TheWayForward/Domesitc-FPGA-Demo-Board/demo/blink/impl/pnr/blink.rpt.txt

//Copyright (C)2014-2022 Gowin Semiconductor Corporation.
//All rights reserved.

1. PnR Messages

  <Report Title>: PnR Report
  <Design File>: C:\Users\TrWyFowrd\Desktop\temp\design_main_test\blink\impl\gwsynthesis\blink.vg
  <Physical Constraints File>: C:\Users\TrWyFowrd\Desktop\temp\design_main_test\blink\src\blink.cst
  <Timing Constraints File>: ---
  <PnR Version>: V1.9.8.10
  <Part Number>: GW2A-LV18PG256C8/I7
  <Device>: GW2A-18
  <Device Version>: C
  <Created Time>:Wed May 24 14:20:20 2023

2. PnR Details

  Running placement:
    Placement Phase 0: CPU time = 0h 0m 0.01s, Elapsed time = 0h 0m 0.012s
    Placement Phase 1: CPU time = 0h 0m 0.185s, Elapsed time = 0h 0m 0.184s
    Placement Phase 2: CPU time = 0h 0m 0s, Elapsed time = 0h 0m 0.001s
    Placement Phase 3: CPU time = 0h 0m 0.645s, Elapsed time = 0h 0m 0.647s
    Total Placement: CPU time = 0h 0m 0.84s, Elapsed time = 0h 0m 0.844s
 Running routing:
    Routing Phase 0: CPU time = 0h 0m 0.001s, Elapsed time = 0h 0m 0.001s
    Routing Phase 1: CPU time = 0h 0m 0.095s, Elapsed time = 0h 0m 0.099s
    Routing Phase 2: CPU time = 0h 0m 0.063s, Elapsed time = 0h 0m 0.061s
    Total Routing: CPU time = 0h 0m 0.159s, Elapsed time = 0h 0m 0.161s
 Generate output files:
    CPU time = 0h 0m 1s, Elapsed time = 0h 0m 1s

 Total Time and Memory Usage: CPU time = 0h 0m 2s, Elapsed time = 0h 0m 2s, Peak memory usage = 320MB

3. Resource Usage Summary

  ----------------------------------------------------------
  Resources                   | Usage
  ----------------------------------------------------------
  Logic                       | 33/20736  <1%
    --LUT,ALU,ROM16           | 33(9 LUT, 24 ALU, 0 ROM16)
    --SSRAM(RAM16)            | 0
  Register                    | 26/16173  <1%
    --Logic Register as Latch | 0/15552  0%
    --Logic Register as FF    | 26/15552  <1%
    --I/O Register as Latch   | 0/621  0%
    --I/O Register as FF      | 0/621  0%
  CLS                         | 19/10368  <1%
  I/O Port                    | 2
  I/O Buf                     | 2
    --Input Buf               | 1
    --Output Buf              | 1
    --Inout Buf               | 0
  IOLOGIC                     | 0%
  BSRAM                       | 0%
  DSP                         | 0%
  PLL                         | 0/4  0%
  DCS                         | 0/8  0%
  DQCE                        | 0/24  0%
  OSC                         | 0/1  0%
  CLKDIV                      | 0/8  0%
  DLLDLY                      | 0/8  0%
  DQS                         | 0/9  0%
  DHCEN                       | 0/16  0%
  ==========================================================

4. I/O Bank Usage Summary

  -----------------------
  I/O Bank  | Usage       
  -----------------------
  bank 0   | 1/29(3%)    
  bank 1   | 0/20(0%)    
  bank 2   | 0/20(0%)    
  bank 3   | 0/32(0%)    
  bank 4   | 0/36(0%)    
  bank 5   | 0/36(0%)    
  bank 6   | 0/18(0%)    
  bank 7   | 1/16(6%)    
  =======================

5. Global Clock Usage Summary

  -------------------------------
  Global Clock  | Usage       
  -------------------------------
  PRIMARY       | 1/8(13%)
  LW            | 0/8(0%)
  GCLK_PIN      | 1/8(13%)
  PLL           | 0/4(0%)
  CLKDIV        | 0/8(0%)
  DLLDLY        | 0/8(0%)
  ===============================

6. Global Clock Signals

  -------------------------------------------
  Signal         | Global Clock   | Location
  -------------------------------------------
  Clock_d        | PRIMARY        |  TR TL BL
  ===========================================

7. Pinout by Port Name

-------------------------------------------------------------------------------------------------------------------------------------------------------------------------------------------------------------------
Port Name   | Diff Pair | Loc./Bank     | Constraint | Dir.  | Site     | IO Type    | Drive | Pull Mode | PCI Clamp | Hysteresis | Open Drain | Slew Rate | Vref       | Single Resistor | Diff Resistor | BankVccio 
-------------------------------------------------------------------------------------------------------------------------------------------------------------------------------------------------------------------
Clock       |           | H11/0         | Y          | in    | IOT27[A] | LVCMOS18   | NA    | UP        | ON        | NONE       | NA         | NA        | NA         | NA              | NA            | 1.8       
IO_voltage  |           | B13/7         | Y          | out   | IOL8[A]  | LVCMOS18   | 8     | UP        | NA        | NA         | OFF        | FAST      | NA         | OFF             | NA            | 1.8       
===================================================================================================================================================================================================================

8. All Package Pins

----------------------------------------------------------------------------------------------------------------------------------------------------------------------------------------
Loc./Bank| Signal      | Dir.  | Site     | IO Type  | Drive | Pull Mode | PCI Clamp | Hysteresis | Open Drain | Slew Rate | Vref       | Single Resistor | Diff Resistor | Bank Vccio
----------------------------------------------------------------------------------------------------------------------------------------------------------------------------------------
L15/0    | -           | in    | IOT2[A]  | LVCMOS18 | NA    | UP        | ON        | NONE       | NA         | NA        | NA         | NA              | NA            | 1.8  
D16/0    | -           | in    | IOT4[A]  | LVCMOS18 | NA    | UP        | ON        | NONE       | NA         | NA        | NA         | NA              | NA            | 1.8  
E14/0    | -           | in    | IOT4[B]  | LVCMOS18 | NA    | UP        | ON        | NONE       | NA         | NA        | NA         | NA              | NA            | 1.8  
C16/0    | -           | in    | IOT5[A]  | LVCMOS18 | NA    | UP        | ON        | NONE       | NA         | NA        | NA         | NA              | NA            | 1.8  
D15/0    | -           | in    | IOT5[B]  | LVCMOS18 | NA    | UP        | ON        | NONE       | NA         | NA        | NA         | NA              | NA            | 1.8  
E16/0    | -           | in    | IOT6[A]  | LVCMOS18 | NA    | UP        | ON        | NONE       | NA         | NA        | NA         | NA              | NA            | 1.8  
F15/0    | -           | in    | IOT6[B]  | LVCMOS18 | NA    | UP        | ON        | NONE       | NA         | NA        | NA         | NA              | NA            | 1.8  
F13/0    | -           | in    | IOT8[A]  | LVCMOS18 | NA    | UP        | ON        | NONE       | NA         | NA        | NA         | NA              | NA            | 1.8  
G12/0    | -           | in    | IOT8[B]  | LVCMOS18 | NA    | UP        | ON        | NONE       | NA         | NA        | NA         | NA              | NA            | 1.8  
F14/0    | -           | in    | IOT9[A]  | LVCMOS18 | NA    | UP        | ON        | NONE       | NA         | NA        | NA         | NA              | NA            | 1.8  
F16/0    | -           | in    | IOT9[B]  | LVCMOS18 | NA    | UP        | ON        | NONE       | NA         | NA        | NA         | NA              | NA            | 1.8  
F12/0    | -           | in    | IOT12[A] | LVCMOS18 | NA    | UP        | ON        | NONE       | NA         | NA        | NA         | NA              | NA            | 1.8  
G13/0    | -           | in    | IOT12[B] | LVCMOS18 | NA    | UP        | ON        | NONE       | NA         | NA        | NA         | NA              | NA            | 1.8  
G15/0    | -           | in    | IOT13[A] | LVCMOS18 | NA    | UP        | ON        | NONE       | NA         | NA        | NA         | NA              | NA            | 1.8  
G14/0    | -           | in    | IOT13[B] | LVCMOS18 | NA    | UP        | ON        | NONE       | NA         | NA        | NA         | NA              | NA            | 1.8  
G11/0    | -           | in    | IOT14[A] | LVCMOS18 | NA    | UP        | ON        | NONE       | NA         | NA        | NA         | NA              | NA            | 1.8  
H12/0    | -           | in    | IOT14[B] | LVCMOS18 | NA    | UP        | ON        | NONE       | NA         | NA        | NA         | NA              | NA            | 1.8  
G16/0    | -           | in    | IOT16[A] | LVCMOS18 | NA    | UP        | ON        | NONE       | NA         | NA        | NA         | NA              | NA            | 1.8  
H15/0    | -           | in    | IOT16[B] | LVCMOS18 | NA    | UP        | ON        | NONE       | NA         | NA        | NA         | NA              | NA            | 1.8  
H13/0    | -           | in    | IOT18[A] | LVCMOS18 | NA    | UP        | ON        | NONE       | NA         | NA        | NA         | NA              | NA            | 1.8  
J12/0    | -           | in    | IOT18[B] | LVCMOS18 | NA    | UP        | ON        | NONE       | NA         | NA        | NA         | NA              | NA            | 1.8  
H14/0    | -           | in    | IOT20[A] | LVCMOS18 | NA    | UP        | ON        | NONE       | NA         | NA        | NA         | NA              | NA            | 1.8  
H16/0    | -           | in    | IOT20[B] | LVCMOS18 | NA    | UP        | ON        | NONE       | NA         | NA        | NA         | NA              | NA            | 1.8  
J16/0    | -           | in    | IOT22[A] | LVCMOS18 | NA    | UP        | ON        | NONE       | NA         | NA        | NA         | NA              | NA            | 1.8  
J14/0    | -           | in    | IOT22[B] | LVCMOS18 | NA    | UP        | ON        | NONE       | NA         | NA        | NA         | NA              | NA            | 1.8  
J15/0    | -           | in    | IOT24[A] | LVCMOS18 | NA    | UP        | ON        | NONE       | NA         | NA        | NA         | NA              | NA            | 1.8  
K16/0    | -           | in    | IOT24[B] | LVCMOS18 | NA    | UP        | ON        | NONE       | NA         | NA        | NA         | NA              | NA            | 1.8  
H11/0    | Clock       | in    | IOT27[A] | LVCMOS18 | NA    | UP        | ON        | NONE       | NA         | NA        | NA         | NA              | NA            | 1.8  
J13/0    | -           | in    | IOT27[B] | LVCMOS18 | NA    | UP        | ON        | NONE       | NA         | NA        | NA         | NA              | NA            | 1.8  
K14/1    | -           | in    | IOT30[A] | LVCMOS18 | NA    | UP        | ON        | NONE       | NA         | NA        | NA         | NA              | NA            | -    
K15/1    | -           | in    | IOT30[B] | LVCMOS18 | NA    | UP        | ON        | NONE       | NA         | NA        | NA         | NA              | NA            | -    
J11/1    | -           | in    | IOT32[A] | LVCMOS18 | NA    | UP        | ON        | NONE       | NA         | NA        | NA         | NA              | NA            | -    
L12/1    | -           | in    | IOT32[B] | LVCMOS18 | NA    | UP        | ON        | NONE       | NA         | NA        | NA         | NA              | NA            | -    
L16/1    | -           | in    | IOT34[A] | LVCMOS18 | NA    | UP        | ON        | NONE       | NA         | NA        | NA         | NA              | NA            | -    
L14/1    | -           | in    | IOT34[B] | LVCMOS18 | NA    | UP        | ON        | NONE       | NA         | NA        | NA         | NA              | NA            | -    
K13/1    | -           | in    | IOT36[A] | LVCMOS18 | NA    | UP        | ON        | NONE       | NA         | NA        | NA         | NA              | NA            | -    
K12/1    | -           | in    | IOT36[B] | LVCMOS18 | NA    | UP        | ON        | NONE       | NA         | NA        | NA         | NA              | NA            | -    
K11/1    | -           | in    | IOT38[A] | LVCMOS18 | NA    | UP        | ON        | NONE       | NA         | NA        | NA         | NA              | NA            | -    
L13/1    | -           | in    | IOT38[B] | LVCMOS18 | NA    | UP        | ON        | NONE       | NA         | NA        | NA         | NA              | NA            | -    
M14/1    | -           | in    | IOT40[A] | LVCMOS18 | NA    | UP        | ON        | NONE       | NA         | NA        | NA         | NA              | NA            | -    
M15/1    | -           | in    | IOT40[B] | LVCMOS18 | NA    | UP        | ON        | NONE       | NA         | NA        | NA         | NA              | NA            | -    
D14/1    | -           | in    | IOT44[A] | LVCMOS18 | NA    | UP        | ON        | NONE       | NA         | NA        | NA         | NA              | NA            | -    
E15/1    | -           | in    | IOT44[B] | LVCMOS18 | NA    | UP        | ON        | NONE       | NA         | NA        | NA         | NA              | NA            | -    
N15/1    | -           | in    | IOT48[A] | LVCMOS18 | NA    | UP        | ON        | NONE       | NA         | NA        | NA         | NA              | NA            | -    
P16/1    | -           | in    | IOT48[B] | LVCMOS18 | NA    | UP        | ON        | NONE       | NA         | NA        | NA         | NA              | NA            | -    
N16/1    | -           | in    | IOT52[A] | LVCMOS18 | NA    | UP        | ON        | NONE       | NA         | NA        | NA         | NA              | NA            | -    
N14/1    | -           | in    | IOT52[B] | LVCMOS18 | NA    | UP        | ON        | NONE       | NA         | NA        | NA         | NA              | NA            | -    
P15/1    | -           | in    | IOT54[A] | LVCMOS18 | NA    | UP        | ON        | NONE       | NA         | NA        | NA         | NA              | NA            | -    
R16/1    | -           | in    | IOT54[B] | LVCMOS18 | NA    | UP        | ON        | NONE       | NA         | NA        | NA         | NA              | NA            | -    
----------------------------------------------------------------------------------------------------------------------------------------------------------------------------------------
A4/5     | -           | in    | IOB2[A]  | LVCMOS18 | NA    | UP        | ON        | NONE       | NA         | NA        | NA         | NA              | NA            | -    
C5/5     | -           | in    | IOB2[B]  | LVCMOS18 | NA    | UP        | ON        | NONE       | NA         | NA        | NA         | NA              | NA            | -    
D6/5     | -           | in    | IOB3[A]  | LVCMOS18 | NA    | UP        | ON        | NONE       | NA         | NA        | NA         | NA              | NA            | -    
E7/5     | -           | in    | IOB3[B]  | LVCMOS18 | NA    | UP        | ON        | NONE       | NA         | NA        | NA         | NA              | NA            | -    
A3/5     | -           | in    | IOB4[A]  | LVCMOS18 | NA    | UP        | ON        | NONE       | NA         | NA        | NA         | NA              | NA            | -    
B4/5     | -           | in    | IOB4[B]  | LVCMOS18 | NA    | UP        | ON        | NONE       | NA         | NA        | NA         | NA              | NA            | -    
A5/5     | -           | in    | IOB7[A]  | LVCMOS18 | NA    | UP        | ON        | NONE       | NA         | NA        | NA         | NA              | NA            | -    
B6/5     | -           | in    | IOB7[B]  | LVCMOS18 | NA    | UP        | ON        | NONE       | NA         | NA        | NA         | NA              | NA            | -    
B1/5     | -           | in    | IOB8[A]  | LVCMOS18 | NA    | UP        | ON        | NONE       | NA         | NA        | NA         | NA              | NA            | -    
C2/5     | -           | in    | IOB8[B]  | LVCMOS18 | NA    | UP        | ON        | NONE       | NA         | NA        | NA         | NA              | NA            | -    
D3/5     | -           | in    | IOB9[A]  | LVCMOS18 | NA    | UP        | ON        | NONE       | NA         | NA        | NA         | NA              | NA            | -    
D1/5     | -           | in    | IOB9[B]  | LVCMOS18 | NA    | UP        | ON        | NONE       | NA         | NA        | NA         | NA              | NA            | -    
E2/5     | -           | in    | IOB12[A] | LVCMOS18 | NA    | UP        | ON        | NONE       | NA         | NA        | NA         | NA              | NA            | -    
E3/5     | -           | in    | IOB12[B] | LVCMOS18 | NA    | UP        | ON        | NONE       | NA         | NA        | NA         | NA              | NA            | -    
B3/5     | -           | in    | IOB13[A] | LVCMOS18 | NA    | UP        | ON        | NONE       | NA         | NA        | NA         | NA              | NA            | -    
A2/5     | -           | in    | IOB13[B] | LVCMOS18 | NA    | UP        | ON        | NONE       | NA         | NA        | NA         | NA              | NA            | -    
C1/5     | -           | in    | IOB14[A] | LVCMOS18 | NA    | UP        | ON        | NONE       | NA         | NA        | NA         | NA              | NA            | -    
D2/5     | -           | in    | IOB14[B] | LVCMOS18 | NA    | UP        | ON        | NONE       | NA         | NA        | NA         | NA              | NA            | -    
E1/5     | -           | in    | IOB16[A] | LVCMOS18 | NA    | UP        | ON        | NONE       | NA         | NA        | NA         | NA              | NA            | -    
F2/5     | -           | in    | IOB16[B] | LVCMOS18 | NA    | UP        | ON        | NONE       | NA         | NA        | NA         | NA              | NA            | -    
F4/5     | -           | in    | IOB18[A] | LVCMOS18 | NA    | UP        | ON        | NONE       | NA         | NA        | NA         | NA              | NA            | -    
G6/5     | -           | in    | IOB18[B] | LVCMOS18 | NA    | UP        | ON        | NONE       | NA         | NA        | NA         | NA              | NA            | -    
F3/5     | -           | in    | IOB19[A] | LVCMOS18 | NA    | UP        | ON        | NONE       | NA         | NA        | NA         | NA              | NA            | -    
F1/5     | -           | in    | IOB19[B] | LVCMOS18 | NA    | UP        | ON        | NONE       | NA         | NA        | NA         | NA              | NA            | -    
G5/5     | -           | in    | IOB20[A] | LVCMOS18 | NA    | UP        | ON        | NONE       | NA         | NA        | NA         | NA              | NA            | -    
G4/5     | -           | in    | IOB20[B] | LVCMOS18 | NA    | UP        | ON        | NONE       | NA         | NA        | NA         | NA              | NA            | -    
G2/5     | -           | in    | IOB21[A] | LVCMOS18 | NA    | UP        | ON        | NONE       | NA         | NA        | NA         | NA              | NA            | -    
G3/5     | -           | in    | IOB21[B] | LVCMOS18 | NA    | UP        | ON        | NONE       | NA         | NA        | NA         | NA              | NA            | -    
F5/5     | -           | in    | IOB22[A] | LVCMOS18 | NA    | UP        | ON        | NONE       | NA         | NA        | NA         | NA              | NA            | -    
H6/5     | -           | in    | IOB22[B] | LVCMOS18 | NA    | UP        | ON        | NONE       | NA         | NA        | NA         | NA              | NA            | -    
G1/5     | -           | in    | IOB24[A] | LVCMOS18 | NA    | UP        | ON        | NONE       | NA         | NA        | NA         | NA              | NA            | -    
H2/5     | -           | in    | IOB24[B] | LVCMOS18 | NA    | UP        | ON        | NONE       | NA         | NA        | NA         | NA              | NA            | -    
H4/5     | -           | in    | IOB26[A] | LVCMOS18 | NA    | UP        | ON        | NONE       | NA         | NA        | NA         | NA              | NA            | -    
J6/5     | -           | in    | IOB26[B] | LVCMOS18 | NA    | UP        | ON        | NONE       | NA         | NA        | NA         | NA              | NA            | -    
J1/5     | -           | in    | IOB27[A] | LVCMOS18 | NA    | UP        | ON        | NONE       | NA         | NA        | NA         | NA              | NA            | -    
J3/5     | -           | in    | IOB27[B] | LVCMOS18 | NA    | UP        | ON        | NONE       | NA         | NA        | NA         | NA              | NA            | -    
L2/4     | -           | in    | IOB30[A] | LVCMOS18 | NA    | UP        | ON        | NONE       | NA         | NA        | NA         | NA              | NA            | -    
M1/4     | -           | in    | IOB30[B] | LVCMOS18 | NA    | UP        | ON        | NONE       | NA         | NA        | NA         | NA              | NA            | -    
H3/4     | -           | in    | IOB32[A] | LVCMOS18 | NA    | UP        | ON        | NONE       | NA         | NA        | NA         | NA              | NA            | -    
H1/4     | -           | in    | IOB32[B] | LVCMOS18 | NA    | UP        | ON        | NONE       | NA         | NA        | NA         | NA              | NA            | -    
J2/4     | -           | in    | IOB34[A] | LVCMOS18 | NA    | UP        | ON        | NONE       | NA         | NA        | NA         | NA              | NA            | -    
K1/4     | -           | in    | IOB34[B] | LVCMOS18 | NA    | UP        | ON        | NONE       | NA         | NA        | NA         | NA              | NA            | -    
H5/4     | -           | in    | IOB35[A] | LVCMOS18 | NA    | UP        | ON        | NONE       | NA         | NA        | NA         | NA              | NA            | -    
J4/4     | -           | in    | IOB35[B] | LVCMOS18 | NA    | UP        | ON        | NONE       | NA         | NA        | NA         | NA              | NA            | -    
K3/4     | -           | in    | IOB36[A] | LVCMOS18 | NA    | UP        | ON        | NONE       | NA         | NA        | NA         | NA              | NA            | -    
K2/4     | -           | in    | IOB36[B] | LVCMOS18 | NA    | UP        | ON        | NONE       | NA         | NA        | NA         | NA              | NA            | -    
J5/4     | -           | in    | IOB37[A] | LVCMOS18 | NA    | UP        | ON        | NONE       | NA         | NA        | NA         | NA              | NA            | -    
K6/4     | -           | in    | IOB37[B] | LVCMOS18 | NA    | UP        | ON        | NONE       | NA         | NA        | NA         | NA              | NA            | -    
L1/4     | -           | in    | IOB38[A] | LVCMOS18 | NA    | UP        | ON        | NONE       | NA         | NA        | NA         | NA              | NA            | -    
L3/4     | -           | in    | IOB38[B] | LVCMOS18 | NA    | UP        | ON        | NONE       | NA         | NA        | NA         | NA              | NA            | -    
K4/4     | -           | in    | IOB39[A] | LVCMOS18 | NA    | UP        | ON        | NONE       | NA         | NA        | NA         | NA              | NA            | -    
L5/4     | -           | in    | IOB39[B] | LVCMOS18 | NA    | UP        | ON        | NONE       | NA         | NA        | NA         | NA              | NA            | -    
K5/4     | -           | in    | IOB40[A] | LVCMOS18 | NA    | UP        | ON        | NONE       | NA         | NA        | NA         | NA              | NA            | -    
L4/4     | -           | in    | IOB40[B] | LVCMOS18 | NA    | UP        | ON        | NONE       | NA         | NA        | NA         | NA              | NA            | -    
N2/4     | -           | in    | IOB41[A] | LVCMOS18 | NA    | UP        | ON        | NONE       | NA         | NA        | NA         | NA              | NA            | -    
P1/4     | -           | in    | IOB41[B] | LVCMOS18 | NA    | UP        | ON        | NONE       | NA         | NA        | NA         | NA              | NA            | -    
M3/4     | -           | in    | IOB42[A] | LVCMOS18 | NA    | UP        | ON        | NONE       | NA         | NA        | NA         | NA              | NA            | -    
N1/4     | -           | in    | IOB42[B] | LVCMOS18 | NA    | UP        | ON        | NONE       | NA         | NA        | NA         | NA              | NA            | -    
M2/4     | -           | in    | IOB43[A] | LVCMOS18 | NA    | UP        | ON        | NONE       | NA         | NA        | NA         | NA              | NA            | -    
N3/4     | -           | in    | IOB43[B] | LVCMOS18 | NA    | UP        | ON        | NONE       | NA         | NA        | NA         | NA              | NA            | -    
R1/4     | -           | in    | IOB44[A] | LVCMOS18 | NA    | UP        | ON        | NONE       | NA         | NA        | NA         | NA              | NA            | -    
P2/4     | -           | in    | IOB44[B] | LVCMOS18 | NA    | UP        | ON        | NONE       | NA         | NA        | NA         | NA              | NA            | -    
P4/4     | -           | in    | IOB45[A] | LVCMOS18 | NA    | UP        | ON        | NONE       | NA         | NA        | NA         | NA              | NA            | -    
T4/4     | -           | in    | IOB45[B] | LVCMOS18 | NA    | UP        | ON        | NONE       | NA         | NA        | NA         | NA              | NA            | -    
R3/4     | -           | in    | IOB48[A] | LVCMOS18 | NA    | UP        | ON        | NONE       | NA         | NA        | NA         | NA              | NA            | -    
T2/4     | -           | in    | IOB48[B] | LVCMOS18 | NA    | UP        | ON        | NONE       | NA         | NA        | NA         | NA              | NA            | -    
P5/4     | -           | in    | IOB50[A] | LVCMOS18 | NA    | UP        | ON        | NONE       | NA         | NA        | NA         | NA              | NA            | -    
R5/4     | -           | in    | IOB50[B] | LVCMOS18 | NA    | UP        | ON        | NONE       | NA         | NA        | NA         | NA              | NA            | -    
R4/4     | -           | in    | IOB52[A] | LVCMOS18 | NA    | UP        | ON        | NONE       | NA         | NA        | NA         | NA              | NA            | -    
T3/4     | -           | in    | IOB52[B] | LVCMOS18 | NA    | UP        | ON        | NONE       | NA         | NA        | NA         | NA              | NA            | -    
R6/4     | -           | in    | IOB54[A] | LVCMOS18 | NA    | UP        | ON        | NONE       | NA         | NA        | NA         | NA              | NA            | -    
T5/4     | -           | in    | IOB54[B] | LVCMOS18 | NA    | UP        | ON        | NONE       | NA         | NA        | NA         | NA              | NA            | -    
----------------------------------------------------------------------------------------------------------------------------------------------------------------------------------------
B14/7    | -           | in    | IOL2[A]  | LVCMOS18 | NA    | UP        | ON        | NONE       | NA         | NA        | NA         | NA              | NA            | 1.8  
A15/7    | -           | in    | IOL2[B]  | LVCMOS18 | NA    | UP        | ON        | NONE       | NA         | NA        | NA         | NA              | NA            | 1.8  
C12/7    | -           | in    | IOL7[A]  | LVCMOS18 | NA    | UP        | ON        | NONE       | NA         | NA        | NA         | NA              | NA            | 1.8  
B12/7    | -           | in    | IOL7[B]  | LVCMOS18 | NA    | UP        | ON        | NONE       | NA         | NA        | NA         | NA              | NA            | 1.8  
B13/7    | IO_voltage  | out   | IOL8[A]  | LVCMOS18 | 8     | UP        | NA        | NA         | OFF        | FAST      | NA         | OFF             | NA            | 1.8  
A14/7    | -           | in    | IOL8[B]  | LVCMOS18 | NA    | UP        | ON        | NONE       | NA         | NA        | NA         | NA              | NA            | 1.8  
F10/7    | -           | in    | IOL11[A] | LVCMOS18 | NA    | UP        | ON        | NONE       | NA         | NA        | NA         | NA              | NA            | 1.8  
B11/7    | -           | in    | IOL13[A] | LVCMOS18 | NA    | UP        | ON        | NONE       | NA         | NA        | NA         | NA              | NA            | 1.8  
A12/7    | -           | in    | IOL13[B] | LVCMOS18 | NA    | UP        | ON        | NONE       | NA         | NA        | NA         | NA              | NA            | 1.8  
A11/7    | -           | in    | IOL15[A] | LVCMOS18 | NA    | UP        | ON        | NONE       | NA         | NA        | NA         | NA              | NA            | 1.8  
C11/7    | -           | in    | IOL15[B] | LVCMOS18 | NA    | UP        | ON        | NONE       | NA         | NA        | NA         | NA              | NA            | 1.8  
D10/7    | -           | in    | IOL17[A] | LVCMOS18 | NA    | UP        | ON        | NONE       | NA         | NA        | NA         | NA              | NA            | 1.8  
E10/7    | -           | in    | IOL17[B] | LVCMOS18 | NA    | UP        | ON        | NONE       | NA         | NA        | NA         | NA              | NA            | 1.8  
D11/7    | -           | in    | IOL22[A] | LVCMOS18 | NA    | UP        | ON        | NONE       | NA         | NA        | NA         | NA              | NA            | 1.8  
A9/7     | -           | in    | IOL27[A] | LVCMOS18 | NA    | UP        | ON        | NONE       | NA         | NA        | NA         | NA              | NA            | 1.8  
C9/7     | -           | in    | IOL27[B] | LVCMOS18 | NA    | UP        | ON        | NONE       | NA         | NA        | NA         | NA              | NA            | 1.8  
C8/6     | -           | in    | IOL29[A] | LVCMOS18 | NA    | UP        | ON        | NONE       | NA         | NA        | NA         | NA              | NA            | -    
A8/6     | -           | in    | IOL29[B] | LVCMOS18 | NA    | UP        | ON        | NONE       | NA         | NA        | NA         | NA              | NA            | -    
F9/6     | -           | in    | IOL31[A] | LVCMOS18 | NA    | UP        | ON        | NONE       | NA         | NA        | NA         | NA              | NA            | -    
E11/6    | -           | in    | IOL31[B] | LVCMOS18 | NA    | UP        | ON        | NONE       | NA         | NA        | NA         | NA              | NA            | -    
B9/6     | -           | in    | IOL33[A] | LVCMOS18 | NA    | UP        | ON        | NONE       | NA         | NA        | NA         | NA              | NA            | -    
A10/6    | -           | in    | IOL33[B] | LVCMOS18 | NA    | UP        | ON        | NONE       | NA         | NA        | NA         | NA              | NA            | -    
F8/6     | -           | in    | IOL35[A] | LVCMOS18 | NA    | UP        | ON        | NONE       | NA         | NA        | NA         | NA              | NA            | -    
D9/6     | -           | in    | IOL35[B] | LVCMOS18 | NA    | UP        | ON        | NONE       | NA         | NA        | NA         | NA              | NA            | -    
D8/6     | -           | in    | IOL38[A] | LVCMOS18 | NA    | UP        | ON        | NONE       | NA         | NA        | NA         | NA              | NA            | -    
E9/6     | -           | in    | IOL38[B] | LVCMOS18 | NA    | UP        | ON        | NONE       | NA         | NA        | NA         | NA              | NA            | -    
B7/6     | -           | in    | IOL40[A] | LVCMOS18 | NA    | UP        | ON        | NONE       | NA         | NA        | NA         | NA              | NA            | -    
C7/6     | -           | in    | IOL40[B] | LVCMOS18 | NA    | UP        | ON        | NONE       | NA         | NA        | NA         | NA              | NA            | -    
F7/6     | -           | in    | IOL45[A] | LVCMOS18 | NA    | UP        | ON        | NONE       | NA         | NA        | NA         | NA              | NA            | -    
E8/6     | -           | in    | IOL45[B] | LVCMOS18 | NA    | UP        | ON        | NONE       | NA         | NA        | NA         | NA              | NA            | -    
C4/6     | -           | in    | IOL47[A] | LVCMOS18 | NA    | UP        | ON        | NONE       | NA         | NA        | NA         | NA              | NA            | -    
B5/6     | -           | in    | IOL47[B] | LVCMOS18 | NA    | UP        | ON        | NONE       | NA         | NA        | NA         | NA              | NA            | -    
E6/6     | -           | in    | IOL53[A] | LVCMOS18 | NA    | UP        | ON        | NONE       | NA         | NA        | NA         | NA              | NA            | -    
D7/6     | -           | in    | IOL53[B] | LVCMOS18 | NA    | UP        | ON        | NONE       | NA         | NA        | NA         | NA              | NA            | -    
----------------------------------------------------------------------------------------------------------------------------------------------------------------------------------------
T15/2    | -           | in    | IOR7[A]  | LVCMOS18 | NA    | UP        | ON        | NONE       | NA         | NA        | NA         | NA              | NA            | -    
R14/2    | -           | in    | IOR7[B]  | LVCMOS18 | NA    | UP        | ON        | NONE       | NA         | NA        | NA         | NA              | NA            | -    
P12/2    | -           | in    | IOR8[A]  | LVCMOS18 | NA    | UP        | ON        | NONE       | NA         | NA        | NA         | NA              | NA            | -    
T13/2    | -           | in    | IOR8[B]  | LVCMOS18 | NA    | UP        | ON        | NONE       | NA         | NA        | NA         | NA              | NA            | -    
R12/2    | -           | in    | IOR11[A] | LVCMOS18 | NA    | UP        | ON        | NONE       | NA         | NA        | NA         | NA              | NA            | -    
P13/2    | -           | in    | IOR11[B] | LVCMOS18 | NA    | UP        | ON        | NONE       | NA         | NA        | NA         | NA              | NA            | -    
R11/2    | -           | in    | IOR17[A] | LVCMOS18 | NA    | UP        | ON        | NONE       | NA         | NA        | NA         | NA              | NA            | -    
T12/2    | -           | in    | IOR17[B] | LVCMOS18 | NA    | UP        | ON        | NONE       | NA         | NA        | NA         | NA              | NA            | -    
R13/2    | -           | in    | IOR20[A] | LVCMOS18 | NA    | UP        | ON        | NONE       | NA         | NA        | NA         | NA              | NA            | -    
T14/2    | -           | in    | IOR20[B] | LVCMOS18 | NA    | UP        | ON        | NONE       | NA         | NA        | NA         | NA              | NA            | -    
M10/2    | -           | in    | IOR22[A] | LVCMOS18 | NA    | UP        | ON        | NONE       | NA         | NA        | NA         | NA              | NA            | -    
N11/2    | -           | in    | IOR22[B] | LVCMOS18 | NA    | UP        | ON        | NONE       | NA         | NA        | NA         | NA              | NA            | -    
T11/2    | -           | in    | IOR24[A] | LVCMOS18 | NA    | UP        | ON        | NONE       | NA         | NA        | NA         | NA              | NA            | -    
P11/2    | -           | in    | IOR24[B] | LVCMOS18 | NA    | UP        | ON        | NONE       | NA         | NA        | NA         | NA              | NA            | -    
C6/2     | -           | out   | IOR25[A] | LVCMOS18 | 8     | UP        | NA        | NA         | OFF        | FAST      | NA         | NA              | NA            | -    
B8/2     | -           | in    | IOR25[B] | LVCMOS18 | NA    | UP        | ON        | NONE       | NA         | NA        | NA         | NA              | NA            | -    
A7/2     | -           | in    | IOR26[A] | LVCMOS18 | NA    | UP        | ON        | NONE       | NA         | NA        | NA         | NA              | NA            | -    
A6/2     | -           | in    | IOR26[B] | LVCMOS18 | NA    | UP        | ON        | NONE       | NA         | NA        | NA         | NA              | NA            | -    
N10/2    | -           | in    | IOR27[A] | LVCMOS18 | NA    | UP        | ON        | NONE       | NA         | NA        | NA         | NA              | NA            | -    
M11/2    | -           | in    | IOR27[B] | LVCMOS18 | NA    | UP        | ON        | NONE       | NA         | NA        | NA         | NA              | NA            | -    
T7/3     | -           | in    | IOR29[A] | LVCMOS18 | NA    | UP        | ON        | NONE       | NA         | NA        | NA         | NA              | NA            | -    
R8/3     | -           | in    | IOR29[B] | LVCMOS18 | NA    | UP        | ON        | NONE       | NA         | NA        | NA         | NA              | NA            | -    
M16/3    | -           | in    | IOR30[A] | LVCMOS18 | NA    | UP        | ON        | NONE       | NA         | NA        | NA         | NA              | NA            | -    
B16/3    | -           | in    | IOR30[B] | LVCMOS18 | NA    | UP        | ON        | NONE       | NA         | NA        | NA         | NA              | NA            | -    
C15/3    | -           | in    | IOR31[A] | LVCMOS18 | NA    | UP        | ON        | NONE       | NA         | NA        | NA         | NA              | NA            | -    
B10/3    | -           | in    | IOR31[B] | LVCMOS18 | NA    | UP        | ON        | NONE       | NA         | NA        | NA         | NA              | NA            | -    
A13/3    | -           | in    | IOR32[A] | LVCMOS18 | NA    | UP        | ON        | NONE       | NA         | NA        | NA         | NA              | NA            | -    
C13/3    | -           | in    | IOR32[B] | LVCMOS18 | NA    | UP        | ON        | NONE       | NA         | NA        | NA         | NA              | NA            | -    
P10/3    | -           | in    | IOR33[A] | LVCMOS18 | NA    | UP        | ON        | NONE       | NA         | NA        | NA         | NA              | NA            | -    
R10/3    | -           | in    | IOR33[B] | LVCMOS18 | NA    | UP        | ON        | NONE       | NA         | NA        | NA         | NA              | NA            | -    
M9/3     | -           | in    | IOR34[A] | LVCMOS18 | NA    | UP        | ON        | NONE       | NA         | NA        | NA         | NA              | NA            | -    
L10/3    | -           | in    | IOR34[B] | LVCMOS18 | NA    | UP        | ON        | NONE       | NA         | NA        | NA         | NA              | NA            | -    
R9/3     | -           | in    | IOR35[A] | LVCMOS18 | NA    | UP        | ON        | NONE       | NA         | NA        | NA         | NA              | NA            | -    
T10/3    | -           | in    | IOR35[B] | LVCMOS18 | NA    | UP        | ON        | NONE       | NA         | NA        | NA         | NA              | NA            | -    
M8/3     | -           | in    | IOR36[A] | LVCMOS18 | NA    | UP        | ON        | NONE       | NA         | NA        | NA         | NA              | NA            | -    
N9/3     | -           | in    | IOR36[B] | LVCMOS18 | NA    | UP        | ON        | NONE       | NA         | NA        | NA         | NA              | NA            | -    
T9/3     | -           | in    | IOR38[A] | LVCMOS18 | NA    | UP        | ON        | NONE       | NA         | NA        | NA         | NA              | NA            | -    
P9/3     | -           | in    | IOR38[B] | LVCMOS18 | NA    | UP        | ON        | NONE       | NA         | NA        | NA         | NA              | NA            | -    
C10/3    | -           | in    | IOR39[A] | LVCMOS18 | NA    | UP        | ON        | NONE       | NA         | NA        | NA         | NA              | NA            | -    
N8/3     | -           | in    | IOR40[A] | LVCMOS18 | NA    | UP        | ON        | NONE       | NA         | NA        | NA         | NA              | NA            | -    
L9/3     | -           | in    | IOR40[B] | LVCMOS18 | NA    | UP        | ON        | NONE       | NA         | NA        | NA         | NA              | NA            | -    
P8/3     | -           | in    | IOR42[A] | LVCMOS18 | NA    | UP        | ON        | NONE       | NA         | NA        | NA         | NA              | NA            | -    
T8/3     | -           | in    | IOR42[B] | LVCMOS18 | NA    | UP        | ON        | NONE       | NA         | NA        | NA         | NA              | NA            | -    
M6/3     | -           | in    | IOR44[A] | LVCMOS18 | NA    | UP        | ON        | NONE       | NA         | NA        | NA         | NA              | NA            | -    
L8/3     | -           | in    | IOR44[B] | LVCMOS18 | NA    | UP        | ON        | NONE       | NA         | NA        | NA         | NA              | NA            | -    
M7/3     | -           | in    | IOR47[A] | LVCMOS18 | NA    | UP        | ON        | NONE       | NA         | NA        | NA         | NA              | NA            | -    
N7/3     | -           | in    | IOR47[B] | LVCMOS18 | NA    | UP        | ON        | NONE       | NA         | NA        | NA         | NA              | NA            | -    
R7/3     | -           | in    | IOR49[A] | LVCMOS18 | NA    | UP        | ON        | NONE       | NA         | NA        | NA         | NA              | NA            | -    
P7/3     | -           | in    | IOR49[B] | LVCMOS18 | NA    | UP        | ON        | NONE       | NA         | NA        | NA         | NA              | NA            | -    
N6/3     | -           | in    | IOR51[A] | LVCMOS18 | NA    | UP        | ON        | NONE       | NA         | NA        | NA         | NA              | NA            | -    
P6/3     | -           | in    | IOR53[A] | LVCMOS18 | NA    | UP        | ON        | NONE       | NA         | NA        | NA         | NA              | NA            | -    
T6/3     | -           | in    | IOR53[B] | LVCMOS18 | NA    | UP        | ON        | NONE       | NA         | NA        | NA         | NA              | NA            | -    
----------------------------------------------------------------------------------------------------------------------------------------------------------------------------------------
========================================================================================================================================================================================
