TheWayForward/Domesitc-FPGA-Demo-Board/image/pcb/design_main_rev2_wb.png

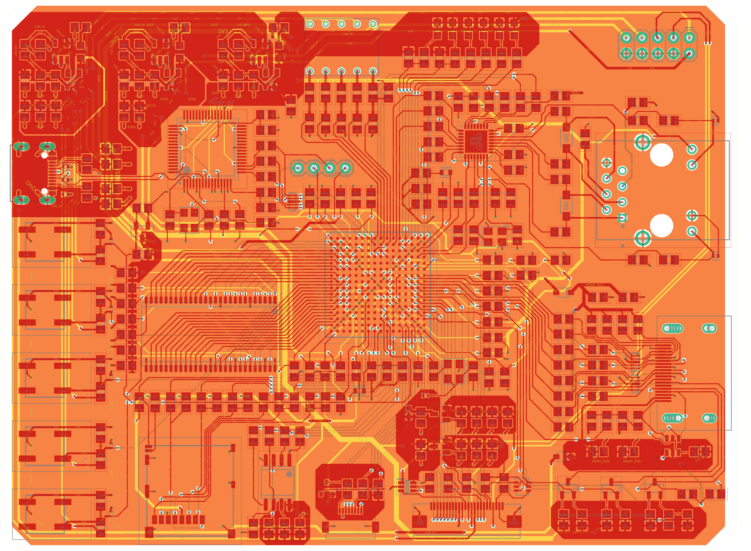
image/pcb/design_main_rev2_wb.png
