TheWayForward/Domesitc-FPGA-Demo-Board/image/pcb/design_main_rev2_wt_1_net.png

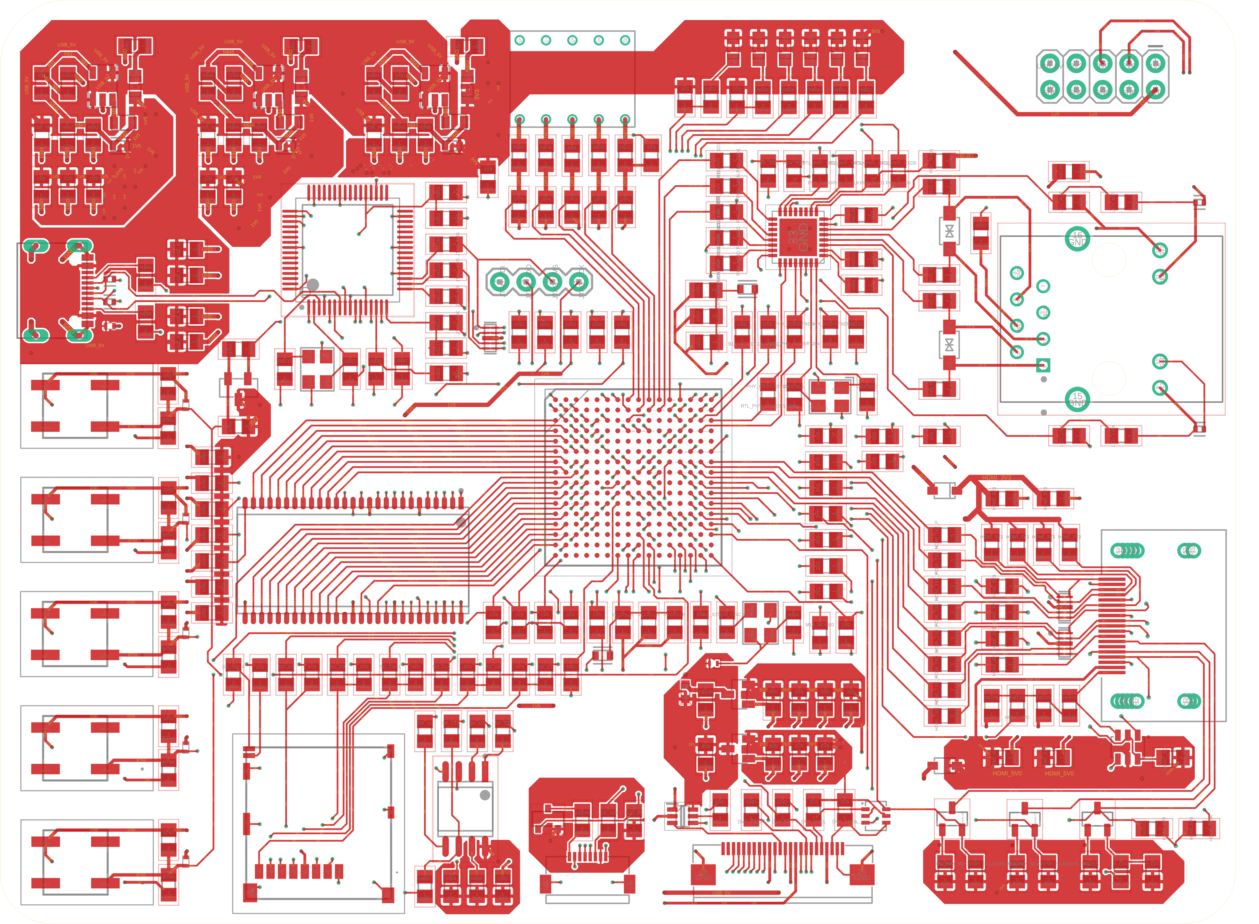
image/pcb/design_main_rev2_wt_1_net.png
