TheWayForward/Domesitc-FPGA-Demo-Board/image/pcb/design_main_rev2_wt_3.png

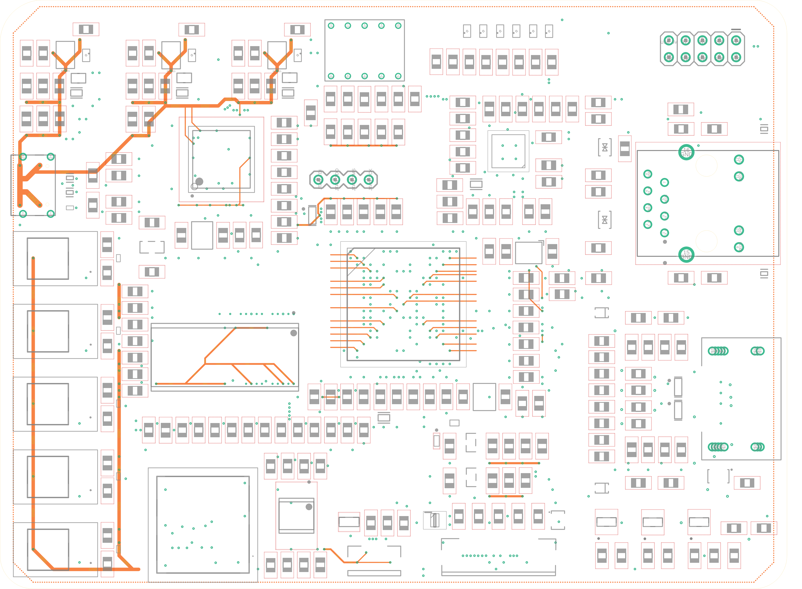
image/pcb/design_main_rev2_wt_3.png
