TheWayForward/Domesitc-FPGA-Demo-Board/image/pcb/design_main_rev2_wt_4.png

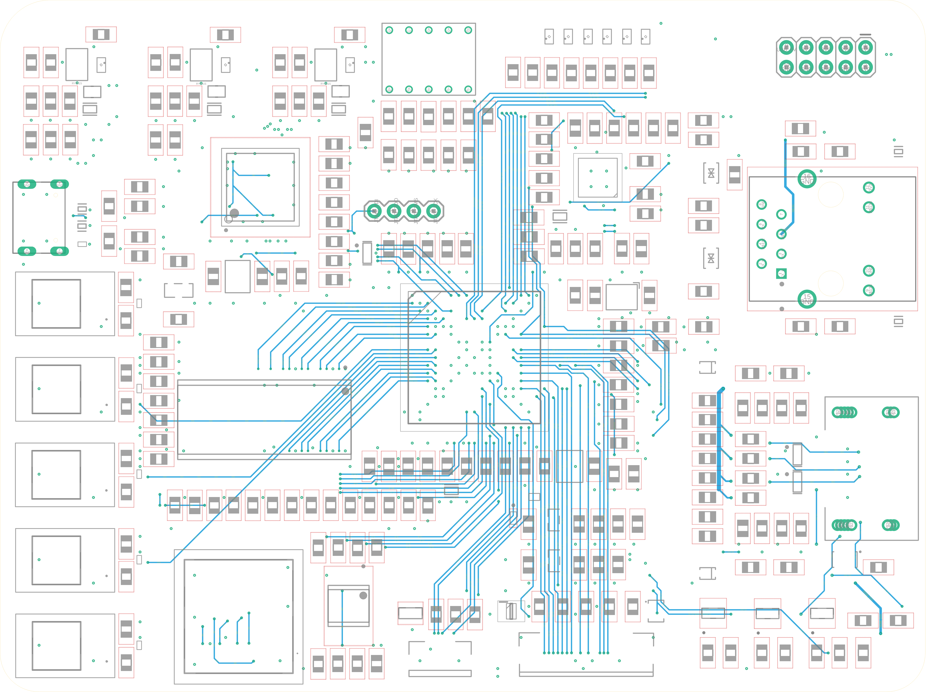
image/pcb/design_main_rev2_wt_4.png
