TheWayForward/Domesitc-FPGA-Demo-Board/image/pcb/jlc_bottom.png

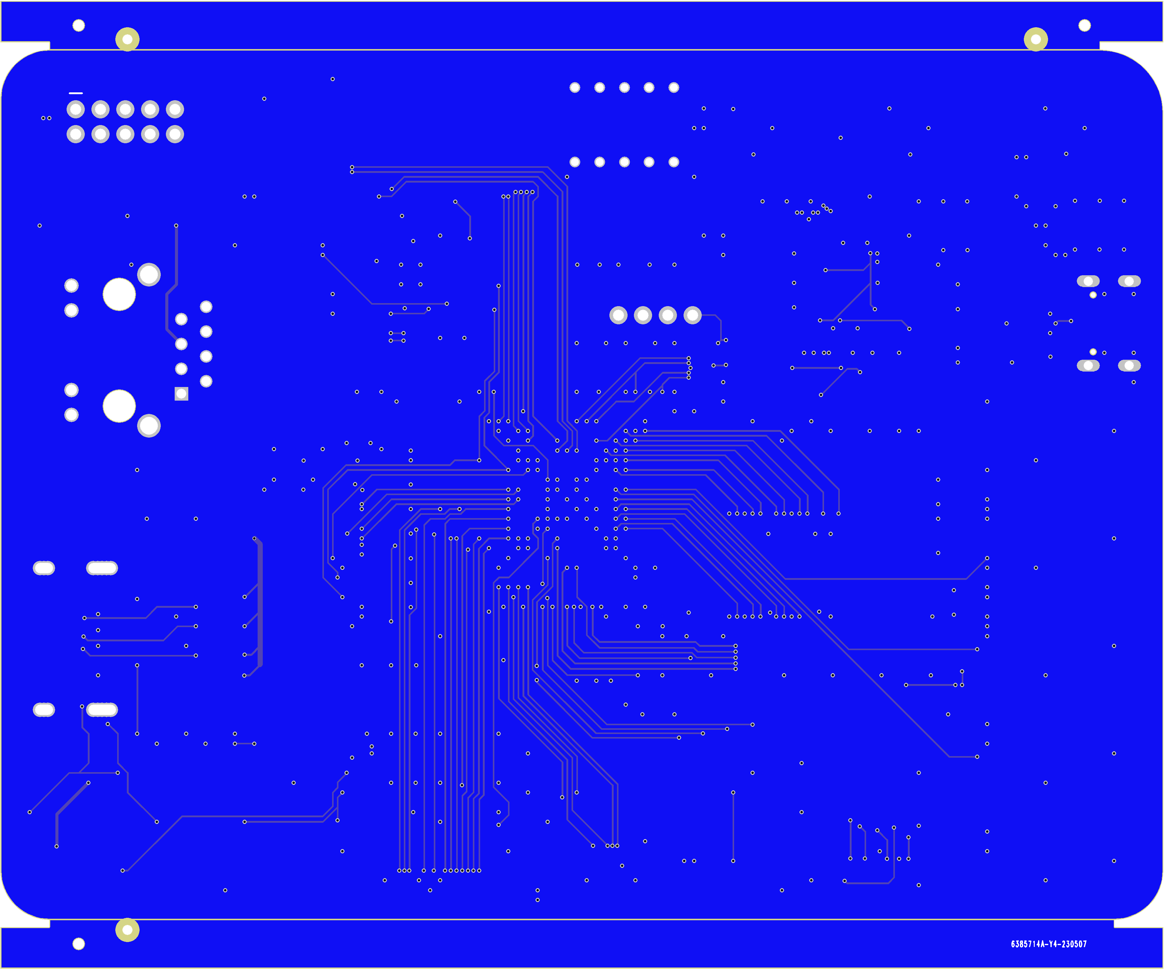
image/pcb/jlc_bottom.png
