TheWayForward/Domesitc-FPGA-Demo-Board/image/pcb/jlc_top.png

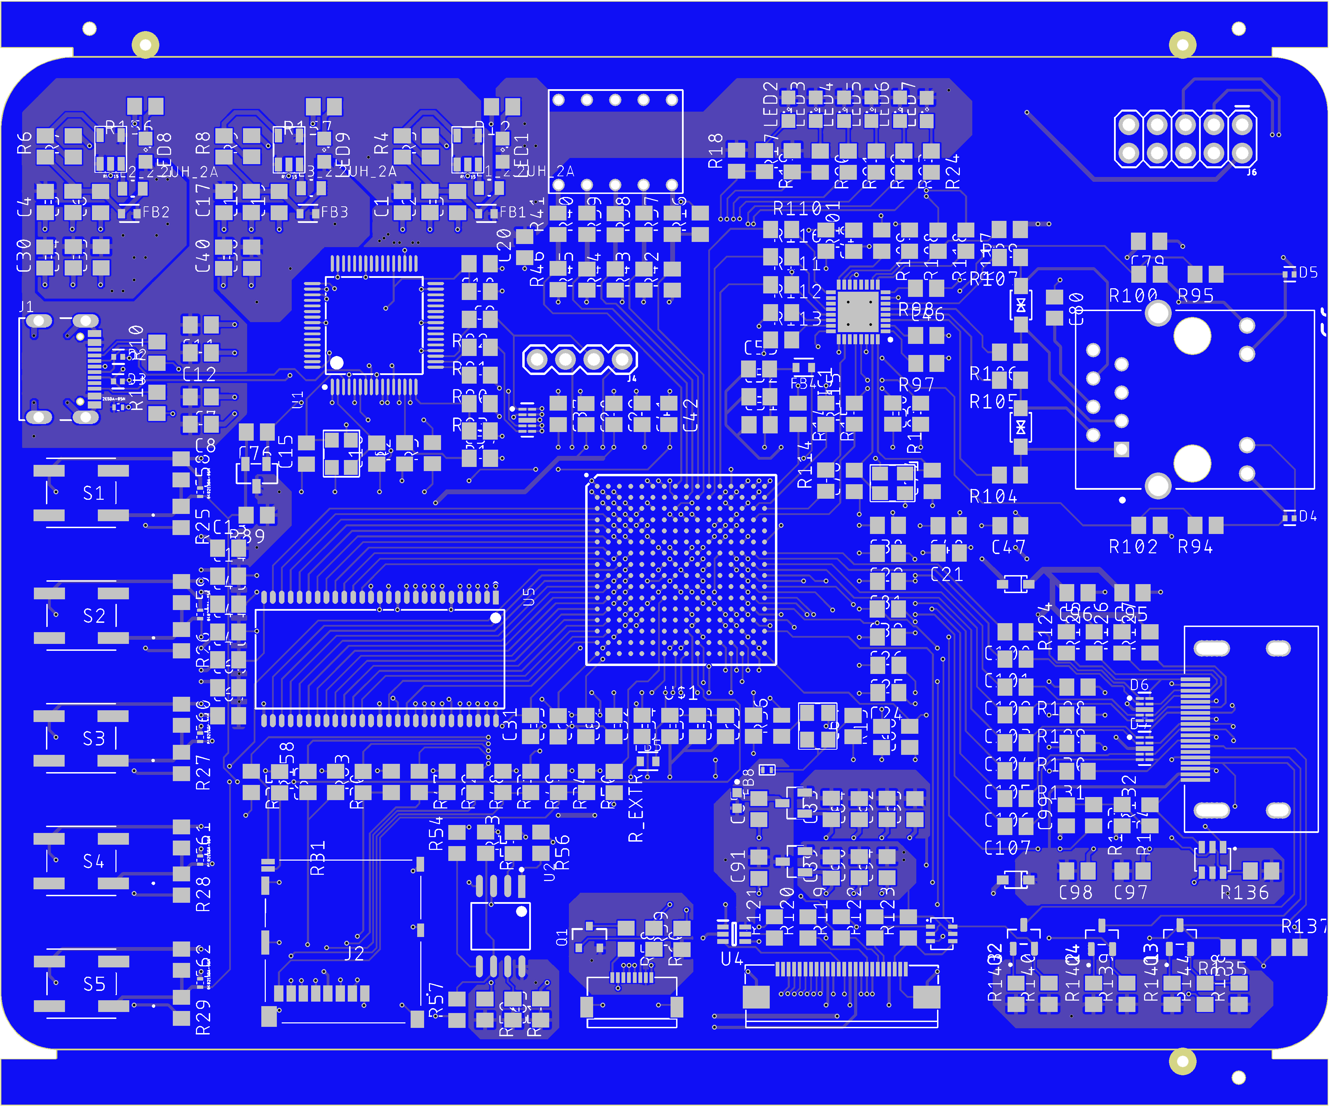
image/pcb/jlc_top.png
