TheWayForward/Domesitc-FPGA-Demo-Board/image/sch/design_main_01.png

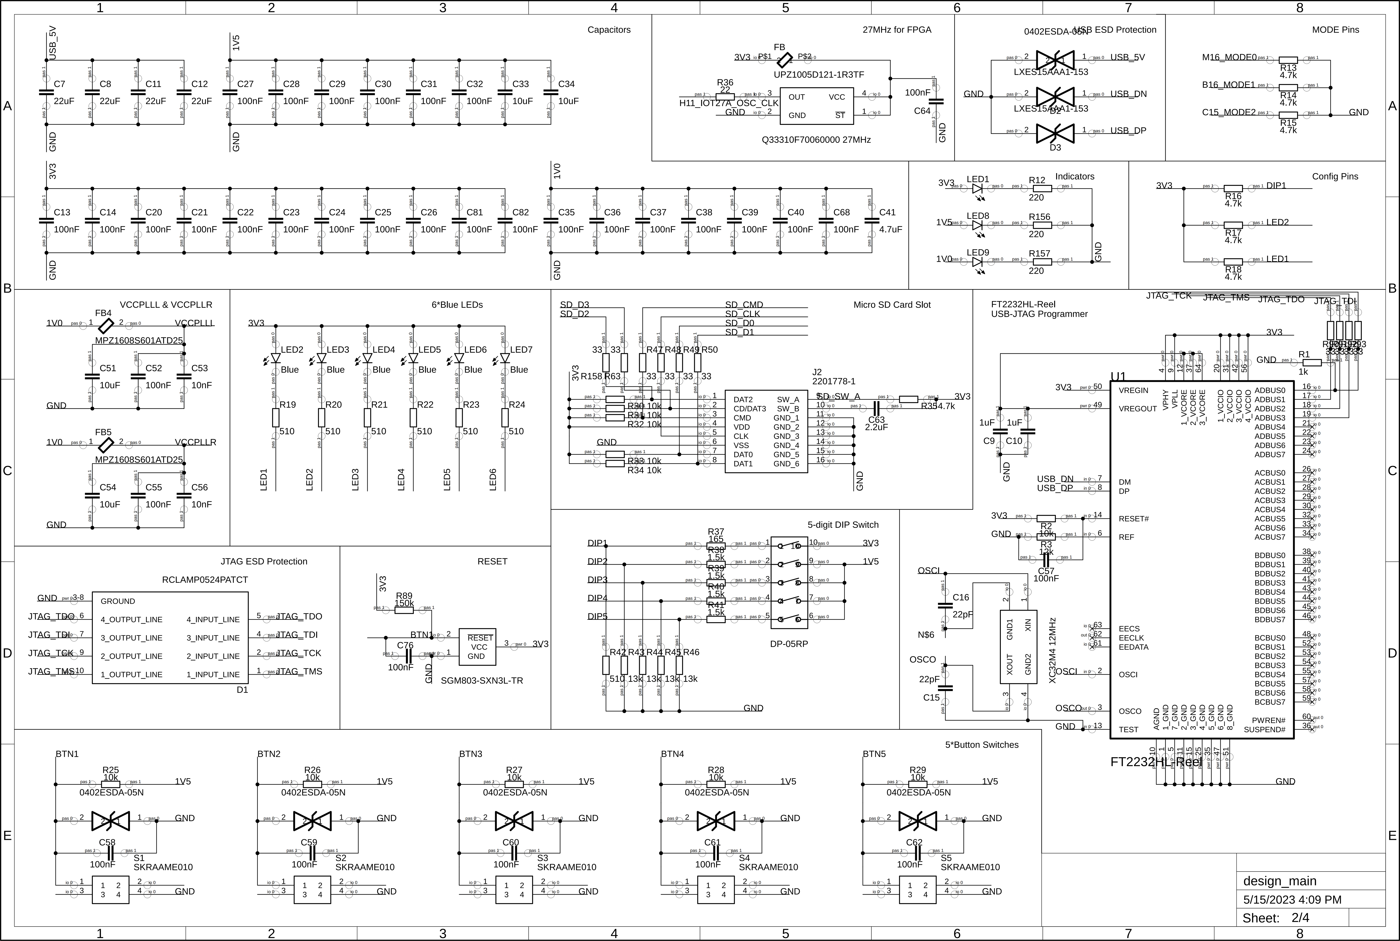
image/sch/design_main_01.png
