TheWayForward/Domesitc-FPGA-Demo-Board/image/sch/design_main_02.png

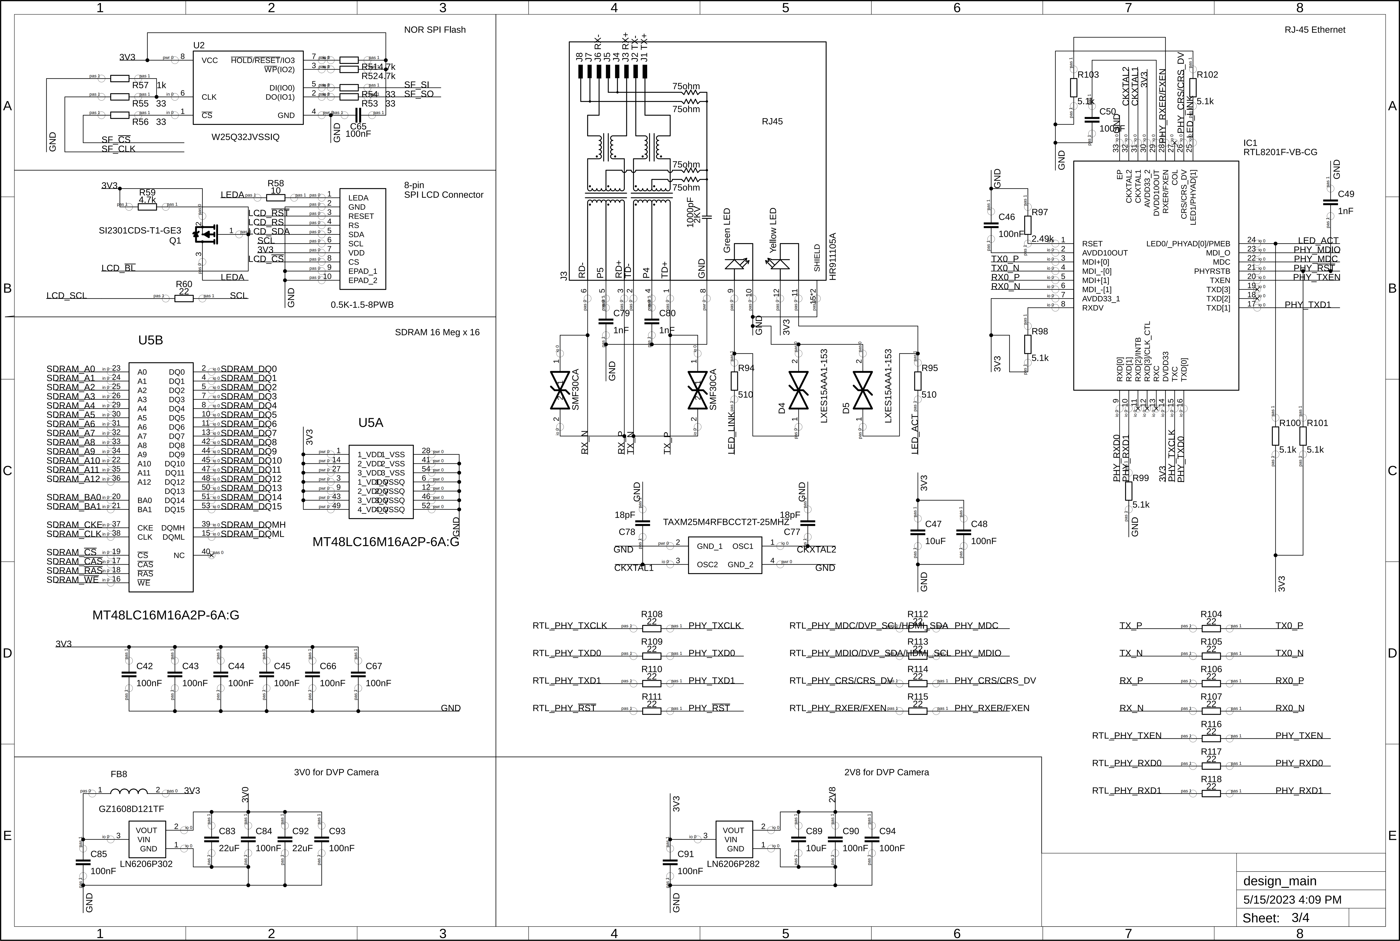
image/sch/design_main_02.png
