TheWayForward/Domesitc-FPGA-Demo-Board/image/sch/design_main_03.png

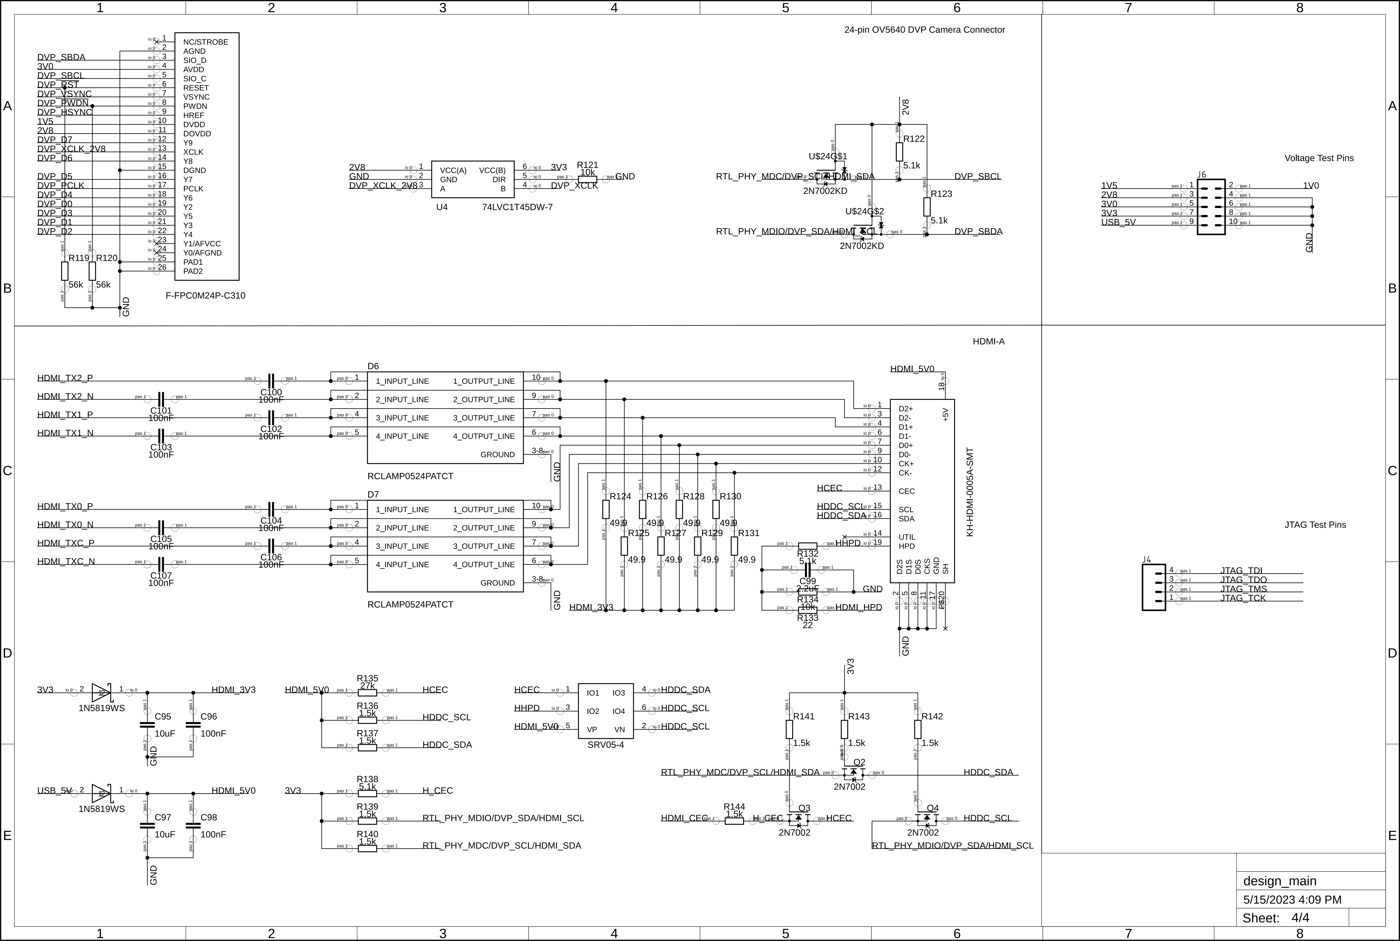
image/sch/design_main_03.png
