TheWayForward/Domesitc-FPGA-Demo-Board/PCBA/Assembly/BOM.xlsx

Description | Comment | Designator | Footprint | 编号
贴片电阻 | 1kΩ | R1 | R0805 | C17513
贴片电阻 | 10kΩ | R2 | R0805 | C844893
贴片电阻 | 12kΩ | R3 | R0805 | C706254
贴片电阻 | 680kΩ | R4 | R0805 | C445667
贴片电阻 | 150kΩ | R5 | R0805 | C17470
贴片电阻 | 150kΩ | R6 | R0805 | C17470
贴片电阻 | 100kΩ | R7 | R0805 | C161786
贴片电阻 | 100kΩ | R8 | R0805 | C161786
贴片电阻 | 150kΩ | R9 | R0805 | C17470
贴片电阻 | 5.1kΩ | R10 | R0805 | C2094165
贴片电阻 | 5.1kΩ | R11 | R0805 | C2094165
贴片电阻 | 220Ω | R12 | R0805 | C445664
贴片电阻 | 4.7kΩ | R13 | R0805 | C17673
贴片电阻 | 4.7kΩ | R14 | R0805 | C17673
贴片电阻 | 4.7kΩ | R15 | R0805 | C17673
贴片电阻 | 4.7kΩ | R16 | R0805 | C17673
贴片电阻 | 4.7kΩ | R17 | R0805 | C17673
贴片电阻 | 4.7kΩ | R18 | R0805 | C17673
贴片电阻 | 510Ω | R19 | R0805 | C17734
贴片电阻 | 510Ω | R20 | R0805 | C17734
贴片电阻 | 510Ω | R21 | R0805 | C17734
贴片电阻 | 510Ω | R22 | R0805 | C17734
贴片电阻 | 510Ω | R23 | R0805 | C17734
贴片电阻 | 510Ω | R24 | R0805 | C17734
贴片电阻 | 10kΩ | R25 | R0805 | C17414
贴片电阻 | 10kΩ | R26 | R0805 | C17414
贴片电阻 | 10kΩ | R27 | R0805 | C17414
贴片电阻 | 10kΩ | R28 | R0805 | C17414
贴片电阻 | 10kΩ | R29 | R0805 | C17414
贴片电阻 | 10kΩ | R30 | R0805 | C17414
贴片电阻 | 10kΩ | R31 | R0805 | C17414
贴片电阻 | 10kΩ | R32 | R0805 | C17414
贴片电阻 | 10kΩ | R33 | R0805 | C17414
贴片电阻 | 10kΩ | R34 | R0805 | C17414
贴片电阻 | 4.7kΩ | R35 | R0805 | C17673
贴片电阻 | 22Ω | R36 | R0805 | C445659
贴片电阻 | 165Ω | R37 | R0805 | C409974
贴片电阻 | 1.5kΩ | R38 | R0805 | C4310
贴片电阻 | 1.5kΩ | R39 | R0805 | C4310
贴片电阻 | 1.5kΩ | R40 | R0805 | C4310
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
以太网连接器 | HR911105A | J3 | 插件 | C12074
4*1排针 | RE-H042TD-1190(LF)(SN) | J4 | 插件,P=2.54mm | C160334
5*2排针 |  | J6
贴片电感 | DFE201208S-2R2M=P2 | L1_2.2UH_2A | 0805 | C2050346
贴片电感 | DFE201208S-2R2M=P2 | L2_2.2UH_2A | 0805 | C2050346
贴片电感 | DFE201208S-2R2M=P2 | L3_2.2UH_2A | 0805 | C2050346
贴片蓝色LED | SMLMN2BCTT86C | LED1 | 0805 | C2837824
贴片蓝色LED | SMLMN2BCTT86C | LED2 | 0805 | C2837824
贴片蓝色LED | SMLMN2BCTT86C | LED3 | 0805 | C2837824
贴片蓝色LED | SMLMN2BCTT86C | LED4 | 0805 | C2837824
贴片蓝色LED | SMLMN2BCTT86C | LED5 | 0805 | C2837824
贴片蓝色LED | SMLMN2BCTT86C | LED6 | 0805 | C2837824
贴片蓝色LED | SMLMN2BCTT86C | LED7 | 0805 | C2837824
贴片蓝色LED | SMLMN2BCTT86C | LED8 | 0805 | C2837824
贴片蓝色LED | SMLMN2BCTT86C | LED9 | 0805 | C2837824
场效应管 | VISHAY_SI2301CDS-T1-GE3 | Q1 | SOT-23 | C10487
场效应管 | 2N7002 | Q2 | SOT-23 | C389059
场效应管 | 2N7002 | Q3 | SOT-23 | C389059
场效应管 | 2N7002 | Q4 | SOT-23 | C389059
贴片电阻 | 10k | R_EXTR | R0805 | C17414
轻触开关 | SKRAAME010 | S1 | SMD | C139788
轻触开关 | SKRAAME010 | S2 | SMD | C139788
轻触开关 | SKRAAME010 | S3 | SMD | C139788
轻触开关 | SKRAAME010 | S4 | SMD | C139788
轻触开关 | SKRAAME010 | S5 | SMD | C139788
FPGA主控芯片 | GW2A-LV18PG256C8I7 | U$1 | BGA256C100P16X16_1700X1700X155 | -
ESD保护 | 0402ESDA-05N | U$10 | 0402 | C316049
ESD保护 | 0402ESDA-05N | U$11 | 0402 | C316049
有源晶振 | Q33310F70060000-27MHZ | U$15 | SMD3225-4P | C59012
拨码开关 | DP-05RP | U$13 | 插件 | C458099
FPC连接器 | 0.5K-1.5-8PWB | U$14 | SMD,P=0.5mm | C2919555
复位芯片 | SGM803-SXN3L-TR | U$16 | SOT-23 | C99577
无源晶振 | TAXM25M4RFBCCT2T-25MHZ | U$17 | SMD3225-4P | C164047
瞬态抑制二极管 | SMF30CA | U$18 | SOD-123FL | C364282
瞬态抑制二极管 | SMF30CA | U$19 | SOD-123FL | C364282
无源晶振 | XC32M4-12MHZ | U$2 | SMD3225-4P | C2842186
线性稳压器 | LN6206P302 | U$20 | SOT-23 | C141408
线性稳压器 | LN6206P282 | U$22 | SOT-23 | C141409
FPC连接器 | F-FPC0M24P-C310 | U$23 | SMD,P=0.5mm | C132514
场效应管 | 2N7002KD | U$24 | SOT-363 | C880912
肖特基二极管 | 1N5819WS | U$25 | SOD-323 | C191023
肖特基二极管 | 1N5819WS | U$26 | SOD-323 | C191023
HDMI-A母座 | KH-HDMI-0005A-SMT | U$27 | SMD | C5204137
ESD保护 | SRV05-4 | U$28 | SOT-23-6 | C558418
DC-DC电源芯片 | RY3415 | U$3 | SOT-23-5 | C370753
DC-DC电源芯片 | RY3415 | U$4 | SOT-23-5 | C370753
DC-DC电源芯片 | RY3415 | U$5 | SOT-23-5 | C370753
ESD保护 | 0402ESDA-05N | U$6 | 0402 | C316049
ESD保护 | 0402ESDA-05N | U$7 | 0402 | C316049
ESD保护 | 0402ESDA-05N | U$8 | 0402 | C316049
ESD保护 | 0402ESDA-05N | U$9 | 0402 | C316049
USB芯片 | FTDI_FT2232HL-REEL | U1 | LQFP-64(10x10) | C27882
NOR SPI Flash | WINBOND_W25Q32JVSSIQ | U2 | SOIC-8-208mil | C179173
电平转换芯片 | 74LVC1T45DW-7 | U4 | SOT-363-6(SC-70-6) | C168855
SDRAM | MICRON_MT48LC16M16A2P-6A-G | U5 | TSOP-54-400mil | C41881
