TheWayForward/Domesitc-FPGA-Demo-Board/image/DS1Z_QuickPrint1.png

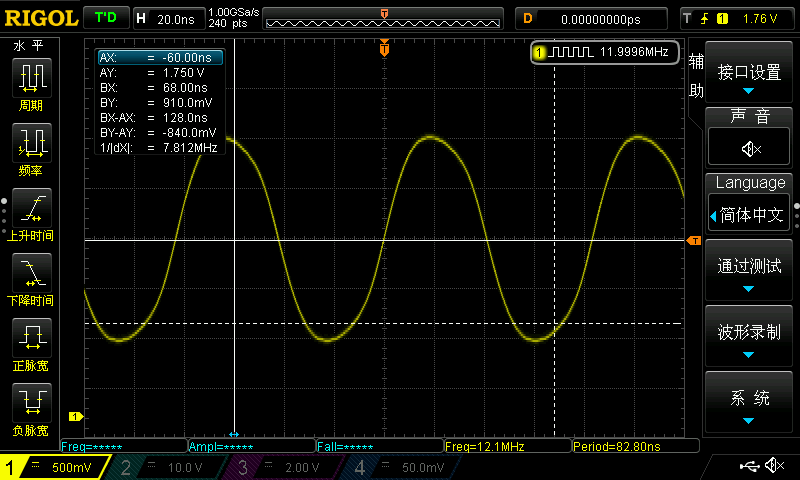
image/DS1Z_QuickPrint1.png
