TheWayForward/Domesitc-FPGA-Demo-Board/image/DS1Z_QuickPrint2.png

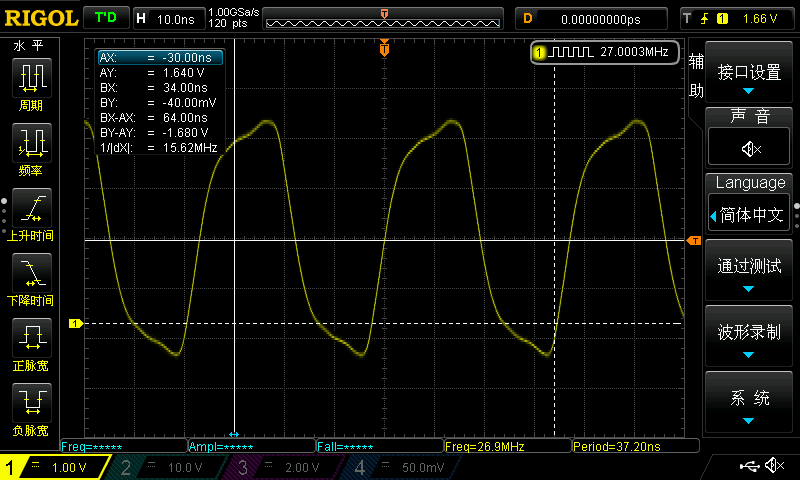
image/DS1Z_QuickPrint2.png
