TheWayForward/Domesitc-FPGA-Demo-Board/image/DS1Z_QuickPrint3.png

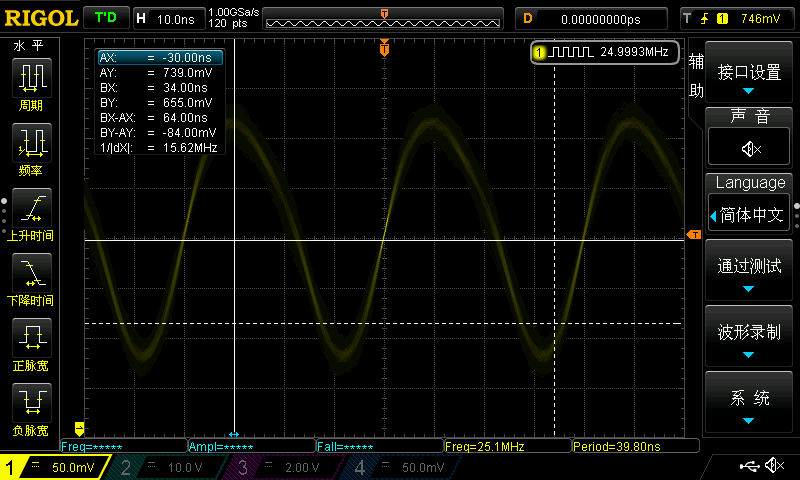
image/DS1Z_QuickPrint3.png
