TheWayForward/Domesitc-FPGA-Demo-Board/demo/spi_lcd/impl/pnr/lcd114_test.rpt.txt

//Copyright (C)2014-2022 Gowin Semiconductor Corporation.
//All rights reserved.

1. PnR Messages

  <Report Title>: PnR Report
  <Design File>: C:\Users\TrWyFowrd\Desktop\temp\design_main_test\spi_lcd\impl\gwsynthesis\lcd114_test.vg
  <Physical Constraints File>: C:\Users\TrWyFowrd\Desktop\temp\design_main_test\spi_lcd\src\lcd114_test.cst
  <Timing Constraints File>: ---
  <PnR Version>: V1.9.8.10
  <Part Number>: GW2A-LV18PG256C8/I7
  <Device>: GW2A-18
  <Device Version>: C
  <Created Time>:Wed May 24 20:55:06 2023

2. PnR Details

  Running placement:
    Placement Phase 0: CPU time = 0h 0m 0.018s, Elapsed time = 0h 0m 0.015s
    Placement Phase 1: CPU time = 0h 0m 0.188s, Elapsed time = 0h 0m 0.189s
    Placement Phase 2: CPU time = 0h 0m 0.019s, Elapsed time = 0h 0m 0.016s
    Placement Phase 3: CPU time = 0h 0m 0.673s, Elapsed time = 0h 0m 0.677s
    Total Placement: CPU time = 0h 0m 0.898s, Elapsed time = 0h 0m 0.897s
 Running routing:
    Routing Phase 0: CPU time = 0h 0m 0s, Elapsed time = 0h 0m 0s
    Routing Phase 1: CPU time = 0h 0m 0.1s, Elapsed time = 0h 0m 0.102s
    Routing Phase 2: CPU time = 0h 0m 0.13s, Elapsed time = 0h 0m 0.13s
    Total Routing: CPU time = 0h 0m 0.23s, Elapsed time = 0h 0m 0.232s
 Generate output files:
    CPU time = 0h 0m 1s, Elapsed time = 0h 0m 1s

 Total Time and Memory Usage: CPU time = 0h 0m 3s, Elapsed time = 0h 0m 3s, Peak memory usage = 321MB

3. Resource Usage Summary

  ----------------------------------------------------------
  Resources                   | Usage
  ----------------------------------------------------------
  Logic                       | 307/20736  2%
    --LUT,ALU,ROM16           | 307(284 LUT, 23 ALU, 0 ROM16)
    --SSRAM(RAM16)            | 0
  Register                    | 74/16173  <1%
    --Logic Register as Latch | 0/15552  0%
    --Logic Register as FF    | 73/15552  <1%
    --I/O Register as Latch   | 0/621  0%
    --I/O Register as FF      | 1/621  <1%
  CLS                         | 171/10368  2%
  I/O Port                    | 8
  I/O Buf                     | 8
    --Input Buf               | 2
    --Output Buf              | 6
    --Inout Buf               | 0
  IOLOGIC                     | 0%
  BSRAM                       | 0%
  DSP                         | 0%
  PLL                         | 0/4  0%
  DCS                         | 0/8  0%
  DQCE                        | 0/24  0%
  OSC                         | 0/1  0%
  CLKDIV                      | 0/8  0%
  DLLDLY                      | 0/8  0%
  DQS                         | 0/9  0%
  DHCEN                       | 0/16  0%
  ==========================================================

4. I/O Bank Usage Summary

  -----------------------
  I/O Bank  | Usage       
  -----------------------
  bank 0   | 1/29(3%)    
  bank 1   | 0/20(0%)    
  bank 2   | 7/20(35%)   
  bank 3   | 0/32(0%)    
  bank 4   | 0/36(0%)    
  bank 5   | 0/36(0%)    
  bank 6   | 0/18(0%)    
  bank 7   | 0/16(0%)    
  =======================

5. Global Clock Usage Summary

  -------------------------------
  Global Clock  | Usage       
  -------------------------------
  PRIMARY       | 1/8(13%)
  LW            | 1/8(13%)
  GCLK_PIN      | 1/8(13%)
  PLL           | 0/4(0%)
  CLKDIV        | 0/8(0%)
  DLLDLY        | 0/8(0%)
  ===============================

6. Global Clock Signals

  -------------------------------------------
  Signal         | Global Clock   | Location
  -------------------------------------------
  clk_d          | PRIMARY        |  TR
  resetn_d       | LW             |  -
  ===========================================

7. Pinout by Port Name

-------------------------------------------------------------------------------------------------------------------------------------------------------------------------------------------------------------------
Port Name   | Diff Pair | Loc./Bank     | Constraint | Dir.  | Site     | IO Type    | Drive | Pull Mode | PCI Clamp | Hysteresis | Open Drain | Slew Rate | Vref       | Single Resistor | Diff Resistor | BankVccio 
-------------------------------------------------------------------------------------------------------------------------------------------------------------------------------------------------------------------
clk         |           | H11/0         | Y          | in    | IOT27[A] | LVCMOS18   | NA    | UP        | ON        | NONE       | NA         | NA        | NA         | NA              | NA            | 1.8       
resetn      |           | P13/2         | N          | in    | IOR11[B] | LVCMOS18   | NA    | UP        | ON        | NONE       | NA         | NA        | NA         | OFF             | NA            | 1.8       
lcd_resetn  |           | R12/2         | Y          | out   | IOR11[A] | LVCMOS18   | 8     | UP        | NA        | NA         | OFF        | FAST      | NA         | OFF             | NA            | 1.8       
lcd_clk     |           | R13/2         | Y          | out   | IOR20[A] | LVCMOS18   | 8     | UP        | NA        | NA         | OFF        | FAST      | NA         | OFF             | NA            | 1.8       
lcd_cs      |           | R14/2         | Y          | out   | IOR7[B]  | LVCMOS18   | 8     | UP        | NA        | NA         | OFF        | FAST      | NA         | OFF             | NA            | 1.8       
lcd_rs      |           | T13/2         | Y          | out   | IOR8[B]  | LVCMOS18   | 8     | UP        | NA        | NA         | OFF        | FAST      | NA         | OFF             | NA            | 1.8       
lcd_data    |           | T14/2         | Y          | out   | IOR20[B] | LVCMOS18   | 8     | UP        | NA        | NA         | OFF        | FAST      | NA         | OFF             | NA            | 1.8       
lcd_bl      |           | T15/2         | Y          | out   | IOR7[A]  | LVCMOS18   | 8     | UP        | NA        | NA         | OFF        | FAST      | NA         | OFF             | NA            | 1.8       
===================================================================================================================================================================================================================

8. All Package Pins

----------------------------------------------------------------------------------------------------------------------------------------------------------------------------------------
Loc./Bank| Signal      | Dir.  | Site     | IO Type  | Drive | Pull Mode | PCI Clamp | Hysteresis | Open Drain | Slew Rate | Vref       | Single Resistor | Diff Resistor | Bank Vccio
----------------------------------------------------------------------------------------------------------------------------------------------------------------------------------------
L15/0    | -           | in    | IOT2[A]  | LVCMOS18 | NA    | UP        | ON        | NONE       | NA         | NA        | NA         | NA              | NA            | 1.8  
D16/0    | -           | in    | IOT4[A]  | LVCMOS18 | NA    | UP        | ON        | NONE       | NA         | NA        | NA         | NA              | NA            | 1.8  
E14/0    | -           | in    | IOT4[B]  | LVCMOS18 | NA    | UP        | ON        | NONE       | NA         | NA        | NA         | NA              | NA            | 1.8  
C16/0    | -           | in    | IOT5[A]  | LVCMOS18 | NA    | UP        | ON        | NONE       | NA         | NA        | NA         | NA              | NA            | 1.8  
D15/0    | -           | in    | IOT5[B]  | LVCMOS18 | NA    | UP        | ON        | NONE       | NA         | NA        | NA         | NA              | NA            | 1.8  
E16/0    | -           | in    | IOT6[A]  | LVCMOS18 | NA    | UP        | ON        | NONE       | NA         | NA        | NA         | NA              | NA            | 1.8  
F15/0    | -           | in    | IOT6[B]  | LVCMOS18 | NA    | UP        | ON        | NONE       | NA         | NA        | NA         | NA              | NA            | 1.8  
F13/0    | -           | in    | IOT8[A]  | LVCMOS18 | NA    | UP        | ON        | NONE       | NA         | NA        | NA         | NA              | NA            | 1.8  
G12/0    | -           | in    | IOT8[B]  | LVCMOS18 | NA    | UP        | ON        | NONE       | NA         | NA        | NA         | NA              | NA            | 1.8  
F14/0    | -           | in    | IOT9[A]  | LVCMOS18 | NA    | UP        | ON        | NONE       | NA         | NA        | NA         | NA              | NA            | 1.8  
F16/0    | -           | in    | IOT9[B]  | LVCMOS18 | NA    | UP        | ON        | NONE       | NA         | NA        | NA         | NA              | NA            | 1.8  
F12/0    | -           | in    | IOT12[A] | LVCMOS18 | NA    | UP        | ON        | NONE       | NA         | NA        | NA         | NA              | NA            | 1.8  
G13/0    | -           | in    | IOT12[B] | LVCMOS18 | NA    | UP        | ON        | NONE       | NA         | NA        | NA         | NA              | NA            | 1.8  
G15/0    | -           | in    | IOT13[A] | LVCMOS18 | NA    | UP        | ON        | NONE       | NA         | NA        | NA         | NA              | NA            | 1.8  
G14/0    | -           | in    | IOT13[B] | LVCMOS18 | NA    | UP        | ON        | NONE       | NA         | NA        | NA         | NA              | NA            | 1.8  
G11/0    | -           | in    | IOT14[A] | LVCMOS18 | NA    | UP        | ON        | NONE       | NA         | NA        | NA         | NA              | NA            | 1.8  
H12/0    | -           | in    | IOT14[B] | LVCMOS18 | NA    | UP        | ON        | NONE       | NA         | NA        | NA         | NA              | NA            | 1.8  
G16/0    | -           | in    | IOT16[A] | LVCMOS18 | NA    | UP        | ON        | NONE       | NA         | NA        | NA         | NA              | NA            | 1.8  
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
========================================================================================================================================================================================
