TheWayForward/Domesitc-FPGA-Demo-Board/demo/spi_lcd/impl/gwsynthesis/lcd114_test_syn.rpt.html

- Synthesis Messages
- Synthesis Details
- Resource
  - Resource Usage Summary
  - Resource Utilization Summary
- Timing
  - Clock Summary
  - Max Frequency Summary
  - Detail Timing Paths Informations

# Synthesis Messages

Report Title | GowinSynthesis Report
Design File | C:\Users\TrWyFowrd\Desktop\temp\design_main_test\spi_lcd\src\top.v
GowinSynthesis Constraints File | ---
Version | GowinSynthesis V1.9.8.10
Part Number | GW2A-LV18PG256C8/I7
Device | GW2A-18
Device Version | C
Created Time | Wed May 24 20:55:01 2023
Legal Announcement | Copyright (C)2014-2022 Gowin Semiconductor Corporation. ALL rights reserved.

# Synthesis Details

Top Level Module | lcd114_test

Synthesis Process

Running parser:
CPU time = 0h 0m 0.171s, Elapsed time = 0h 0m 0.168s, Peak memory usage = 104.355MB
Running netlist conversion:
CPU time = 0h 0m 0s, Elapsed time = 0h 0m 0s, Peak memory usage = 0MB
Running device independent optimization:
Optimizing Phase 0: CPU time = 0h 0m 0.015s, Elapsed time = 0h 0m 0.012s, Peak memory usage = 104.355MB
Optimizing Phase 1: CPU time = 0h 0m 0s, Elapsed time = 0h 0m 0.006s, Peak memory usage = 104.355MB
Optimizing Phase 2: CPU time = 0h 0m 0.031s, Elapsed time = 0h 0m 0.019s, Peak memory usage = 104.355MB
Running inference:
Inferring Phase 0: CPU time = 0h 0m 0s, Elapsed time = 0h 0m 0.002s, Peak memory usage = 104.355MB
Inferring Phase 1: CPU time = 0h 0m 0s, Elapsed time = 0h 0m 0.001s, Peak memory usage = 104.355MB
Inferring Phase 2: CPU time = 0h 0m 0s, Elapsed time = 0h 0m 0.001s, Peak memory usage = 104.355MB
Inferring Phase 3: CPU time = 0h 0m 0s, Elapsed time = 0h 0m 0s, Peak memory usage = 104.355MB
Running technical mapping:
Tech-Mapping Phase 0: CPU time = 0h 0m 0.015s, Elapsed time = 0h 0m 0.019s, Peak memory usage = 104.355MB
Tech-Mapping Phase 1: CPU time = 0h 0m 0.015s, Elapsed time = 0h 0m 0.008s, Peak memory usage = 104.355MB
Tech-Mapping Phase 2: CPU time = 0h 0m 0s, Elapsed time = 0h 0m 0.003s, Peak memory usage = 104.355MB
Tech-Mapping Phase 3: CPU time = 0h 0m 2s, Elapsed time = 0h 0m 2s, Peak memory usage = 117.629MB
Tech-Mapping Phase 4: CPU time = 0h 0m 0.015s, Elapsed time = 0h 0m 0.01s, Peak memory usage = 117.629MB
Generate output files:
CPU time = 0h 0m 0s, Elapsed time = 0h 0m 0.015s, Peak memory usage = 117.629MB
Total Time and Memory Usage | CPU time = 0h 0m 2s, Elapsed time = 0h 0m 2s, Peak memory usage = 117.629MB

# Resource

## Resource Usage Summary

Resource | Usage
I/O Port | 8
I/O Buf | 8
IBUF | 2
OBUF | 6
Register | 74
DFFPE | 10
DFFCE | 64
LUT | 281
LUT2 | 26
LUT3 | 47
LUT4 | 208
ALU | 21
ALU | 21
INV | 4
INV | 4

## Resource Utilization Summary

Resource | Usage | Utilization
Logic | 306(285 LUTs, 21 ALUs) / 20736 | 2%
Register | 74 / 16173 | <1%
--Register as Latch | 0 / 16173 | 0%
--Register as FF | 74 / 16173 | <1%
BSRAM | 0 / 46 | 0%

# Timing

## Clock Summary:

Clock Name | Type | Period | Frequency(MHz) | Rise | Fall | Source | Master | Object
clk | Base | 10.000 | 100.0 | 0.000 | 5.000 | | | clk_ibuf/I

## Max Frequency Summary:

No. | Clock Name | Constraint | Actual Fmax | Logic Level | Entity
1 | clk | 100.0(MHz) | 225.9(MHz) | 6 | TOP

## Detail Timing Paths Information

### Path 1

Path Summary:

Slack | 5.574
Data Arrival Time | 5.253
Data Required Time | 10.828
From | pixel_cnt_5_s0
To | spi_data_2_s2
Launch Clk | clk[R]
Latch Clk | clk[R]

Data Arrival Path:

AT | DELAY | TYPE | RF | FANOUT | NODE
0.000 | 0.000 | | | | clk
0.000 | 0.000 | tCL | RR | 1 | clk_ibuf/I
0.683 | 0.683 | tINS | RR | 75 | clk_ibuf/O
0.863 | 0.180 | tNET | RR | 1 | pixel_cnt_5_s0/CLK
1.095 | 0.232 | tC2Q | RF | 4 | pixel_cnt_5_s0/Q
1.332 | 0.237 | tNET | FF | 1 | n1293_s31/I1
1.887 | 0.555 | tINS | FF | 1 | n1293_s31/F
2.124 | 0.237 | tNET | FF | 1 | n1293_s26/I1
2.679 | 0.555 | tINS | FF | 3 | n1293_s26/F
2.916 | 0.237 | tNET | FF | 1 | n1303_s21/I0
3.433 | 0.517 | tINS | FF | 1 | n1303_s21/F
3.670 | 0.237 | tNET | FF | 1 | n1303_s15/I1
4.225 | 0.555 | tINS | FF | 1 | n1303_s15/F
4.462 | 0.237 | tNET | FF | 1 | n1303_s13/I1
5.016 | 0.555 | tINS | FF | 1 | n1303_s13/F
5.253 | 0.237 | tNET | FF | 1 | spi_data_2_s2/D

Data Required Path:

AT | DELAY | TYPE | RF | FANOUT | NODE
10.000 | 0.000 | | | | clk
10.000 | 0.000 | tCL | RR | 1 | clk_ibuf/I
10.682 | 0.683 | tINS | RR | 75 | clk_ibuf/O
10.863 | 0.180 | tNET | RR | 1 | spi_data_2_s2/CLK
10.828 | -0.035 | tSu | | 1 | spi_data_2_s2

Path Statistics:

Clock Skew: | 0.000
Setup Relationship: | 10.000
Logic Level: | 6
Arrival Clock Path Delay: | cell: 0.683, 79.130%; route: 0.180, 20.870%
Arrival Data Path Delay: | cell: 2.737, 62.332%; route: 1.422, 32.384%; tC2Q: 0.232, 5.284%
Required Clock Path Delay: | cell: 0.683, 79.130%; route: 0.180, 20.870%

### Path 2

Path Summary:

Slack | 5.574
Data Arrival Time | 5.253
Data Required Time | 10.828
From | clk_cnt_13_s1
To | clk_cnt_1_s1
Launch Clk | clk[R]
Latch Clk | clk[R]

Data Arrival Path:

AT | DELAY | TYPE | RF | FANOUT | NODE
0.000 | 0.000 | | | | clk
0.000 | 0.000 | tCL | RR | 1 | clk_ibuf/I
0.683 | 0.683 | tINS | RR | 75 | clk_ibuf/O
0.863 | 0.180 | tNET | RR | 1 | clk_cnt_13_s1/CLK
1.095 | 0.232 | tC2Q | RF | 7 | clk_cnt_13_s1/Q
1.332 | 0.237 | tNET | FF | 1 | n1653_s7/I1
1.887 | 0.555 | tINS | FF | 1 | n1653_s7/F
2.124 | 0.237 | tNET | FF | 1 | n1653_s3/I1
2.679 | 0.555 | tINS | FF | 2 | n1653_s3/F
2.916 | 0.237 | tNET | FF | 1 | n1281_s22/I1
3.471 | 0.555 | tINS | FF | 3 | n1281_s22/F
3.708 | 0.237 | tNET | FF | 1 | init_state_2_s8/I0
4.225 | 0.517 | tINS | FF | 30 | init_state_2_s8/F
4.462 | 0.237 | tNET | FF | 1 | n1275_s7/I1
5.016 | 0.555 | tINS | FF | 1 | n1275_s7/F
5.253 | 0.237 | tNET | FF | 1 | clk_cnt_1_s1/D

Data Required Path:

AT | DELAY | TYPE | RF | FANOUT | NODE
10.000 | 0.000 | | | | clk
10.000 | 0.000 | tCL | RR | 1 | clk_ibuf/I
10.682 | 0.683 | tINS | RR | 75 | clk_ibuf/O
10.863 | 0.180 | tNET | RR | 1 | clk_cnt_1_s1/CLK
10.828 | -0.035 | tSu | | 1 | clk_cnt_1_s1

Path Statistics:

Clock Skew: | 0.000
Setup Relationship: | 10.000
Logic Level: | 6
Arrival Clock Path Delay: | cell: 0.683, 79.130%; route: 0.180, 20.870%
Arrival Data Path Delay: | cell: 2.737, 62.332%; route: 1.422, 32.384%; tC2Q: 0.232, 5.284%
Required Clock Path Delay: | cell: 0.683, 79.130%; route: 0.180, 20.870%

### Path 3

Path Summary:

Slack | 5.574
Data Arrival Time | 5.253
Data Required Time | 10.828
From | clk_cnt_13_s1
To | clk_cnt_2_s1
Launch Clk | clk[R]
Latch Clk | clk[R]

Data Arrival Path:

AT | DELAY | TYPE | RF | FANOUT | NODE
0.000 | 0.000 | | | | clk
0.000 | 0.000 | tCL | RR | 1 | clk_ibuf/I
0.683 | 0.683 | tINS | RR | 75 | clk_ibuf/O
0.863 | 0.180 | tNET | RR | 1 | clk_cnt_13_s1/CLK
1.095 | 0.232 | tC2Q | RF | 7 | clk_cnt_13_s1/Q
1.332 | 0.237 | tNET | FF | 1 | n1653_s7/I1
1.887 | 0.555 | tINS | FF | 1 | n1653_s7/F
2.124 | 0.237 | tNET | FF | 1 | n1653_s3/I1
2.679 | 0.555 | tINS | FF | 2 | n1653_s3/F
2.916 | 0.237 | tNET | FF | 1 | n1281_s22/I1
3.471 | 0.555 | tINS | FF | 3 | n1281_s22/F
3.708 | 0.237 | tNET | FF | 1 | init_state_2_s8/I0
4.225 | 0.517 | tINS | FF | 30 | init_state_2_s8/F
4.462 | 0.237 | tNET | FF | 1 | n1273_s7/I1
5.016 | 0.555 | tINS | FF | 1 | n1273_s7/F
5.253 | 0.237 | tNET | FF | 1 | clk_cnt_2_s1/D

Data Required Path:

AT | DELAY | TYPE | RF | FANOUT | NODE
10.000 | 0.000 | | | | clk
10.000 | 0.000 | tCL | RR | 1 | clk_ibuf/I
10.682 | 0.683 | tINS | RR | 75 | clk_ibuf/O
10.863 | 0.180 | tNET | RR | 1 | clk_cnt_2_s1/CLK
10.828 | -0.035 | tSu | | 1 | clk_cnt_2_s1

Path Statistics:

Clock Skew: | 0.000
Setup Relationship: | 10.000
Logic Level: | 6
Arrival Clock Path Delay: | cell: 0.683, 79.130%; route: 0.180, 20.870%
Arrival Data Path Delay: | cell: 2.737, 62.332%; route: 1.422, 32.384%; tC2Q: 0.232, 5.284%
Required Clock Path Delay: | cell: 0.683, 79.130%; route: 0.180, 20.870%

### Path 4

Path Summary:

Slack | 5.574
Data Arrival Time | 5.253
Data Required Time | 10.828
From | clk_cnt_13_s1
To | clk_cnt_3_s1
Launch Clk | clk[R]
Latch Clk | clk[R]

Data Arrival Path:

AT | DELAY | TYPE | RF | FANOUT | NODE
0.000 | 0.000 | | | | clk
0.000 | 0.000 | tCL | RR | 1 | clk_ibuf/I
0.683 | 0.683 | tINS | RR | 75 | clk_ibuf/O
0.863 | 0.180 | tNET | RR | 1 | clk_cnt_13_s1/CLK
1.095 | 0.232 | tC2Q | RF | 7 | clk_cnt_13_s1/Q
1.332 | 0.237 | tNET | FF | 1 | n1653_s7/I1
1.887 | 0.555 | tINS | FF | 1 | n1653_s7/F
2.124 | 0.237 | tNET | FF | 1 | n1653_s3/I1
2.679 | 0.555 | tINS | FF | 2 | n1653_s3/F
2.916 | 0.237 | tNET | FF | 1 | n1281_s22/I1
3.471 | 0.555 | tINS | FF | 3 | n1281_s22/F
3.708 | 0.237 | tNET | FF | 1 | init_state_2_s8/I0
4.225 | 0.517 | tINS | FF | 30 | init_state_2_s8/F
4.462 | 0.237 | tNET | FF | 1 | n1271_s7/I1
5.016 | 0.555 | tINS | FF | 1 | n1271_s7/F
5.253 | 0.237 | tNET | FF | 1 | clk_cnt_3_s1/D

Data Required Path:

AT | DELAY | TYPE | RF | FANOUT | NODE
10.000 | 0.000 | | | | clk
10.000 | 0.000 | tCL | RR | 1 | clk_ibuf/I
10.682 | 0.683 | tINS | RR | 75 | clk_ibuf/O
10.863 | 0.180 | tNET | RR | 1 | clk_cnt_3_s1/CLK
10.828 | -0.035 | tSu | | 1 | clk_cnt_3_s1

Path Statistics:

Clock Skew: | 0.000
Setup Relationship: | 10.000
Logic Level: | 6
Arrival Clock Path Delay: | cell: 0.683, 79.130%; route: 0.180, 20.870%
Arrival Data Path Delay: | cell: 2.737, 62.332%; route: 1.422, 32.384%; tC2Q: 0.232, 5.284%
Required Clock Path Delay: | cell: 0.683, 79.130%; route: 0.180, 20.870%

### Path 5

Path Summary:

Slack | 5.574
Data Arrival Time | 5.253
Data Required Time | 10.828
From | clk_cnt_13_s1
To | clk_cnt_4_s1
Launch Clk | clk[R]
Latch Clk | clk[R]

Data Arrival Path:

AT | DELAY | TYPE | RF | FANOUT | NODE
0.000 | 0.000 | | | | clk
0.000 | 0.000 | tCL | RR | 1 | clk_ibuf/I
0.683 | 0.683 | tINS | RR | 75 | clk_ibuf/O
0.863 | 0.180 | tNET | RR | 1 | clk_cnt_13_s1/CLK
1.095 | 0.232 | tC2Q | RF | 7 | clk_cnt_13_s1/Q
1.332 | 0.237 | tNET | FF | 1 | n1653_s7/I1
1.887 | 0.555 | tINS | FF | 1 | n1653_s7/F
2.124 | 0.237 | tNET | FF | 1 | n1653_s3/I1
2.679 | 0.555 | tINS | FF | 2 | n1653_s3/F
2.916 | 0.237 | tNET | FF | 1 | n1281_s22/I1
3.471 | 0.555 | tINS | FF | 3 | n1281_s22/F
3.708 | 0.237 | tNET | FF | 1 | init_state_2_s8/I0
4.225 | 0.517 | tINS | FF | 30 | init_state_2_s8/F
4.462 | 0.237 | tNET | FF | 1 | n1269_s7/I1
5.016 | 0.555 | tINS | FF | 1 | n1269_s7/F
5.253 | 0.237 | tNET | FF | 1 | clk_cnt_4_s1/D

Data Required Path:

AT | DELAY | TYPE | RF | FANOUT | NODE
10.000 | 0.000 | | | | clk
10.000 | 0.000 | tCL | RR | 1 | clk_ibuf/I
10.682 | 0.683 | tINS | RR | 75 | clk_ibuf/O
10.863 | 0.180 | tNET | RR | 1 | clk_cnt_4_s1/CLK
10.828 | -0.035 | tSu | | 1 | clk_cnt_4_s1

Path Statistics:

Clock Skew: | 0.000
Setup Relationship: | 10.000
Logic Level: | 6
Arrival Clock Path Delay: | cell: 0.683, 79.130%; route: 0.180, 20.870%
Arrival Data Path Delay: | cell: 2.737, 62.332%; route: 1.422, 32.384%; tC2Q: 0.232, 5.284%
Required Clock Path Delay: | cell: 0.683, 79.130%; route: 0.180, 20.870%
