TheWayForward/Domesitc-FPGA-Demo-Board/PCB/design_main.brd

## EAGLE design PCB/design_main.brd (2023-05-30)

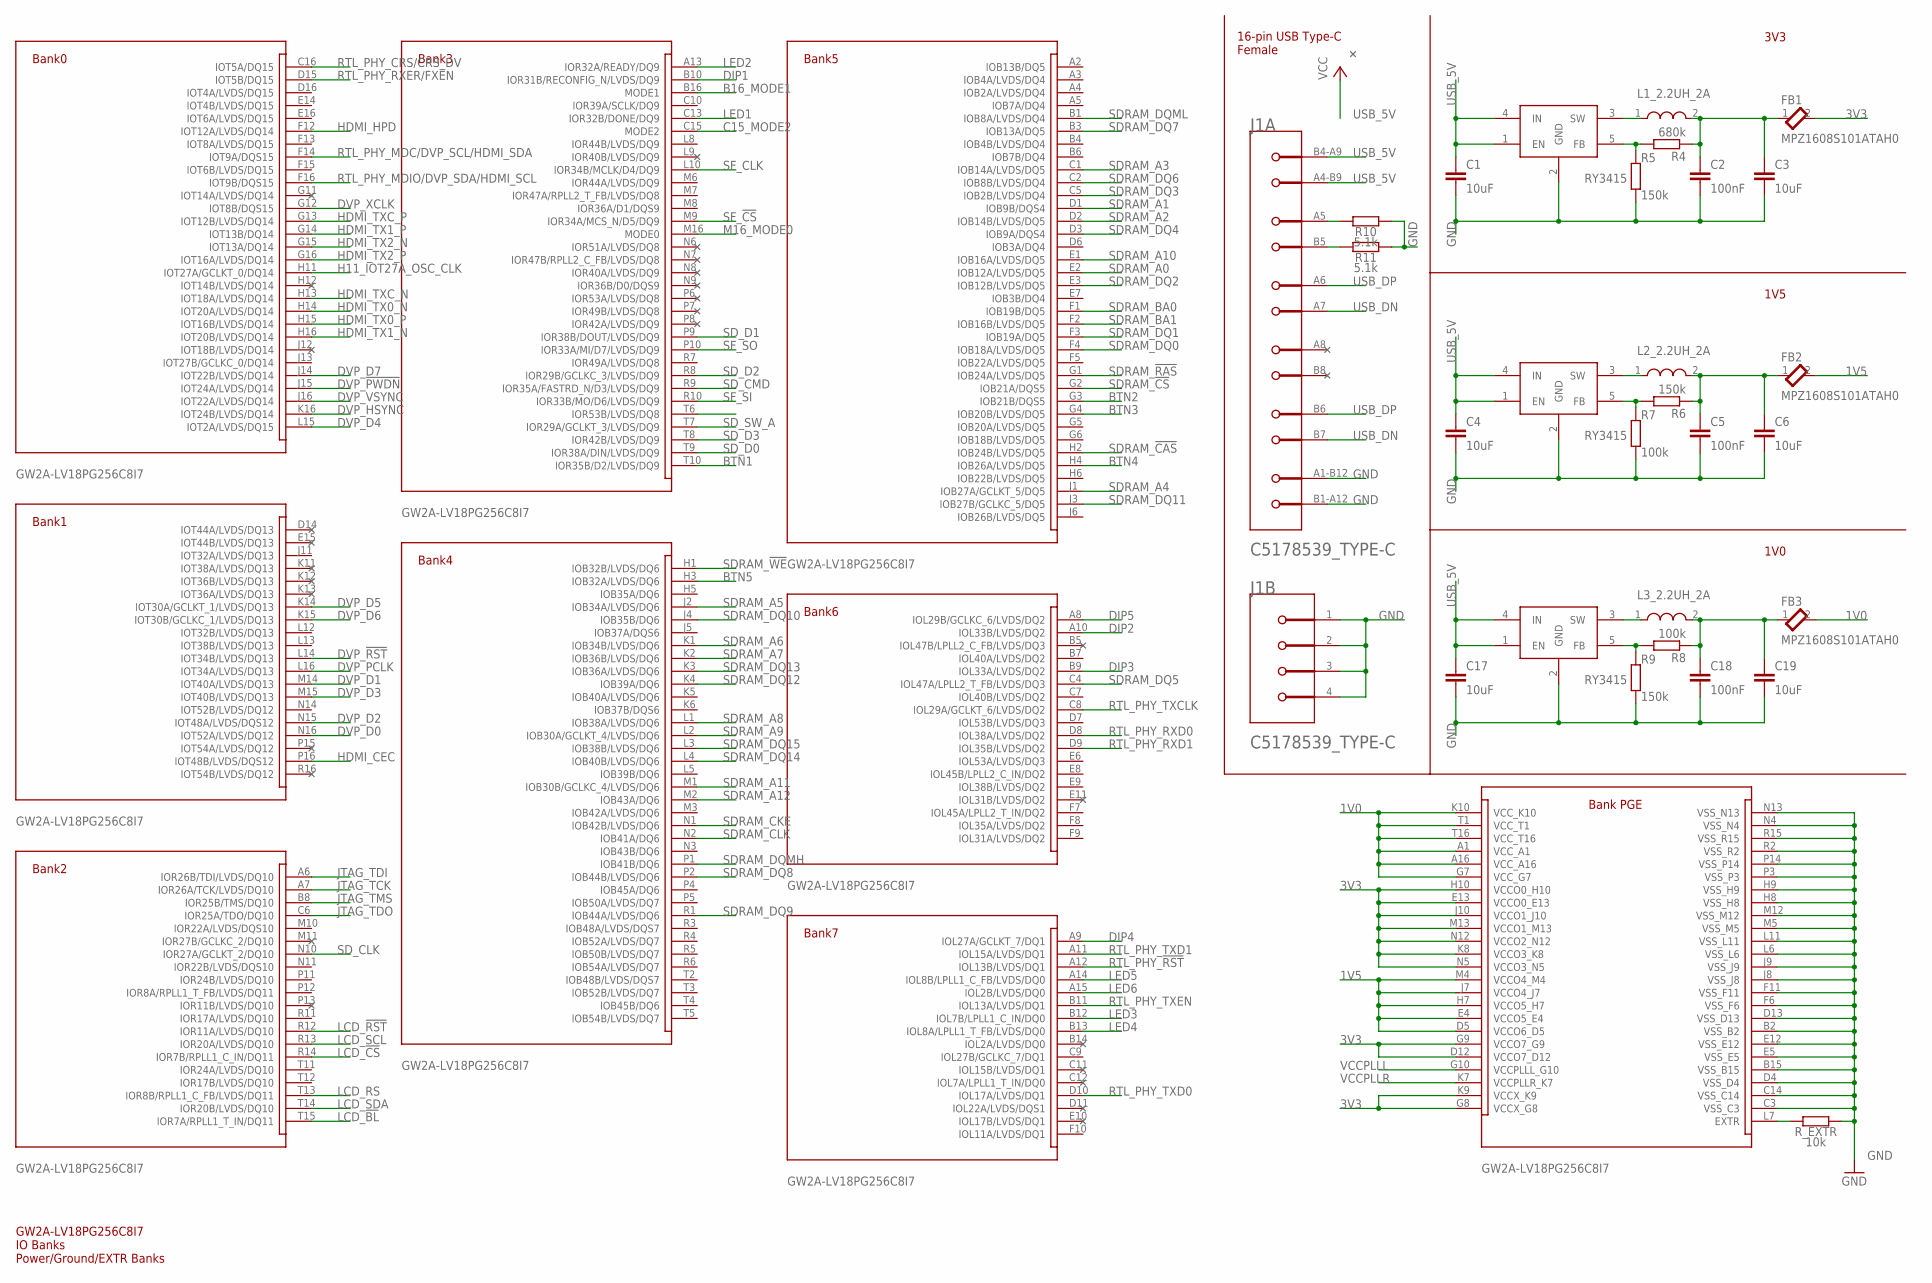
[picture p18: schematic design_main.sch, sheet 1]

Parts:
C1, C3, C4, C6, C17, C19: 10uF; C0805
C2, C5, C18: 100nF; C0805
FB1, FB2, FB3: TDK_MPZ1608S101ATAH0TDK_MPZ1608S101ATAH0_0_0; TDK_MPZ1608S101ATAH0_0
J1: C5178539_TYPE-CMOLEX_217179-0001_0_0; C5178539_TYPE-C
L1_2.2UH_2A: L_0805TDK_MLZ2012N6R8LT000_0_0; TDK_MLZ2012N6R8LT000_0
L2_2.2UH_2A, L3_2.2UH_2A: 2.2uH 2A; TDK_MLZ2012N6R8LT000_0
R4: 680k; R0805
R5, R6, R9: 150k; R0805
R7, R8: 100k; R0805
R10, R11: 5.1k; R0805
R_EXTR: 10k; R0805
U$1: GW2A-LV18PG256C8I7; BGA256C100P16X16_1700X1700X155
U$3, U$4, U$5: RY3415

Connections:
1V0: FB3.2, U$1.A1 (VCC_A1), U$1.A16 (VCC_A16), U$1.G7 (VCC_G7), U$1.K10 (VCC_K10), U$1.T1 (VCC_T1), U$1.T16 (VCC_T16); also elsewhere on the board
1V5: FB2.2, U$1.D5 (VCCO6_D5), U$1.E4 (VCCO5_E4), U$1.H7 (VCCO5_H7), U$1.J7 (VCCO4_J7), U$1.M4 (VCCO4_M4); also elsewhere on the board
3V3: FB1.2, U$1.D12 (VCCO7_D12), U$1.E13 (VCCO0_E13), U$1.G8 (VCCX_G8), U$1.G9 (VCCO7_G9), U$1.H10 (VCCO0_H10), U$1.J10 (VCCO1_J10), U$1.K8 (VCCO3_K8), U$1.K9 (VCCX_K9), U$1.M13 (VCCO1_M13), U$1.N5 (VCCO3_N5), U$1.N12 (VCCO2_N12); also elsewhere on the board
B16_MODE1: U$1.B16 (MODE1); also elsewhere on the board
BTN1: U$1.T10 (IOR35B/D2/LVDS/DQ9); also elsewhere on the board
BTN2: U$1.G3 (IOB21B/DQS5); also elsewhere on the board
BTN3: U$1.G4 (IOB20B/LVDS/DQ5); also elsewhere on the board
BTN4: U$1.H4 (IOB26A/LVDS/DQ5); also elsewhere on the board
BTN5: U$1.H3 (IOB32A/LVDS/DQ6); also elsewhere on the board
C15_MODE2: U$1.C15 (MODE2); also elsewhere on the board
DIP1: U$1.B10 (IOR31B/RECONFIG_N/LVDS/DQ9); also elsewhere on the board
DIP2: U$1.A10 (IOL33B/LVDS/DQ2); also elsewhere on the board
DIP3: U$1.B9 (IOL33A/LVDS/DQ2); also elsewhere on the board
DIP4: U$1.A9 (IOL27A/GCLKT_7/DQ1); also elsewhere on the board
DIP5: U$1.A8 (IOL29B/GCLKC_6/LVDS/DQ2); also elsewhere on the board
DVP_!PWDN!: U$1.J15 (IOT24A/LVDS/DQ14); also elsewhere on the board
DVP_!RST!: U$1.L14 (IOT34B/LVDS/DQ13); also elsewhere on the board
DVP_D0: U$1.N16 (IOT52A/LVDS/DQ12); also elsewhere on the board
DVP_D1: U$1.M14 (IOT40A/LVDS/DQ13); also elsewhere on the board
DVP_D2: U$1.N15 (IOT48A/LVDS/DQS12); also elsewhere on the board
DVP_D3: U$1.M15 (IOT40B/LVDS/DQ13); also elsewhere on the board
DVP_D4: U$1.L15 (IOT2A/LVDS/DQ15); also elsewhere on the board
DVP_D5: U$1.K14 (IOT30A/GCLKT_1/LVDS/DQ13); also elsewhere on the board
DVP_D6: U$1.K15 (IOT30B/GCLKC_1/LVDS/DQ13); also elsewhere on the board
DVP_D7: U$1.J14 (IOT22B/LVDS/DQ14); also elsewhere on the board
DVP_HSYNC: U$1.K16 (IOT24B/LVDS/DQ14); also elsewhere on the board
DVP_PCLK: U$1.L16 (IOT34A/LVDS/DQ13); also elsewhere on the board
DVP_VSYNC: U$1.J16 (IOT22A/LVDS/DQ14); also elsewhere on the board
DVP_XCLK: U$1.G12 (IOT8B/DQS15); also elsewhere on the board
GND: C1.1, C2.1, C3.1, C4.1, C5.1, C6.1, C17.1, C18.1, C19.1, J1.1 (MNT_1), J1.2 (MNT_2), J1.3 (MNT_3), J1.4 (MNT_4), J1.A1-B12 (1_GND), J1.B1-A12 (2_GND), R5.2, R7.2, R9.2, R10.1, R11.1, R_EXTR.2, U$1.B2 (VSS_B2), U$1.B15 (VSS_B15), U$1.C3 (VSS_C3), U$1.C14 (VSS_C14), U$1.D4 (VSS_D4), U$1.D13 (VSS_D13), U$1.E5 (VSS_E5), U$1.E12 (VSS_E12), U$1.F6 (VSS_F6), U$1.F11 (VSS_F11), U$1.H8 (VSS_H8), U$1.H9 (VSS_H9), U$1.J8 (VSS_J8), U$1.J9 (VSS_J9), U$1.L6 (VSS_L6), U$1.L11 (VSS_L11), U$1.M5 (VSS_M5), U$1.M12 (VSS_M12), U$1.N4 (VSS_N4), U$1.N13 (VSS_N13), U$1.P3 (VSS_P3), U$1.P14 (VSS_P14), U$1.R2 (VSS_R2), U$1.R15 (VSS_R15), U$3.2 (GND), U$4.2 (GND), U$5.2 (GND); also elsewhere on the board
H11_IOT27A_OSC_CLK: U$1.H11 (IOT27A/GCLKT_0/DQ14); also elsewhere on the board
HDMI_CEC: U$1.P16 (IOT48B/LVDS/DQS12); also elsewhere on the board
HDMI_HPD: U$1.F12 (IOT12A/LVDS/DQ14); also elsewhere on the board
HDMI_TX0_N: U$1.H14 (IOT20A/LVDS/DQ14); also elsewhere on the board
HDMI_TX0_P: U$1.H15 (IOT16B/LVDS/DQ14); also elsewhere on the board
HDMI_TX1_N: U$1.H16 (IOT20B/LVDS/DQ14); also elsewhere on the board
HDMI_TX1_P: U$1.G14 (IOT13B/DQ14); also elsewhere on the board
HDMI_TX2_N: U$1.G15 (IOT13A/DQ14); also elsewhere on the board
HDMI_TX2_P: U$1.G16 (IOT16A/LVDS/DQ14); also elsewhere on the board
HDMI_TXC_N: U$1.H13 (IOT18A/LVDS/DQ14); also elsewhere on the board
HDMI_TXC_P: U$1.G13 (IOT12B/LVDS/DQ14); also elsewhere on the board
JTAG_TCK: U$1.A7 (IOR26A/TCK/LVDS/DQ10); also elsewhere on the board
JTAG_TDI: U$1.A6 (IOR26B/TDI/LVDS/DQ10); also elsewhere on the board
JTAG_TDO: U$1.C6 (IOR25A/TDO/DQ10); also elsewhere on the board
JTAG_TMS: U$1.B8 (IOR25B/TMS/DQ10); also elsewhere on the board
LCD_!BL!: U$1.T15 (IOR7A/RPLL1_T_IN/DQ11); also elsewhere on the board
LCD_!CS!: U$1.R14 (IOR7B/RPLL1_C_IN/DQ11); also elsewhere on the board
LCD_!RST!: U$1.R12 (IOR11A/LVDS/DQ10); also elsewhere on the board
LCD_RS: U$1.T13 (IOR8B/RPLL1_C_FB/LVDS/DQ11); also elsewhere on the board
LCD_SCL: U$1.R13 (IOR20A/LVDS/DQ10); also elsewhere on the board
LCD_SDA: U$1.T14 (IOR20B/LVDS/DQ10); also elsewhere on the board
LED1: U$1.C13 (IOR32B/DONE/DQ9); also elsewhere on the board
LED2: U$1.A13 (IOR32A/READY/DQ9); also elsewhere on the board
LED3: U$1.B12 (IOL7B/LPLL1_C_IN/DQ0); also elsewhere on the board
LED4: U$1.B13 (IOL8A/LPLL1_T_FB/LVDS/DQ0); also elsewhere on the board
LED5: U$1.A14 (IOL8B/LPLL1_C_FB/LVDS/DQ0); also elsewhere on the board
LED6: U$1.A15 (IOL2B/LVDS/DQ0); also elsewhere on the board
M16_MODE0: U$1.M16 (MODE0); also elsewhere on the board
unnamed: R6.2, R7.1, U$4.5 (FB)
unnamed: R_EXTR.1, U$1.L7 (EXTR)
unnamed: L2_2.2UH_2A.1, U$4.3 (SW)
unnamed: C5.2, C6.2, FB2.1, L2_2.2UH_2A.2, R6.1
unnamed: R4.2, R5.1, U$3.5 (FB)
unnamed: L1_2.2UH_2A.1, U$3.3 (SW)
unnamed: C2.2, C3.2, FB1.1, L1_2.2UH_2A.2, R4.1
unnamed: R8.2, R9.1, U$5.5 (FB)
unnamed: L3_2.2UH_2A.1, U$5.3 (SW)
unnamed: C18.2, C19.2, FB3.1, L3_2.2UH_2A.2, R8.1
unnamed: J1.A5 (CC1), R10.2
unnamed: J1.B5 (CC2), R11.2
RTL_PHY_!RST!: U$1.A12 (IOL13B/LVDS/DQ1); also elsewhere on the board
RTL_PHY_CRS/CRS_DV: U$1.C16 (IOT5A/DQ15); also elsewhere on the board
RTL_PHY_MDC/DVP_SCL/HDMI_SDA: U$1.F14 (IOT9A/DQS15); also elsewhere on the board
RTL_PHY_MDIO/DVP_SDA/HDMI_SCL: U$1.F16 (IOT9B/DQS15); also elsewhere on the board
RTL_PHY_RXD0: U$1.D8 (IOL38A/LVDS/DQ2); also elsewhere on the board
RTL_PHY_RXD1: U$1.D9 (IOL35B/LVDS/DQ2); also elsewhere on the board
RTL_PHY_RXER/FXEN: U$1.D15 (IOT5B/DQ15); also elsewhere on the board
RTL_PHY_TXCLK: U$1.C8 (IOL29A/GCLKT_6/LVDS/DQ2); also elsewhere on the board
RTL_PHY_TXD0: U$1.D10 (IOL17A/LVDS/DQ1); also elsewhere on the board
RTL_PHY_TXD1: U$1.A11 (IOL15A/LVDS/DQ1); also elsewhere on the board
RTL_PHY_TXEN: U$1.B11 (IOL13A/LVDS/DQ1); also elsewhere on the board
SDRAM_!CAS!: U$1.H2 (IOB24B/LVDS/DQ5); also elsewhere on the board
SDRAM_!CS!: U$1.G2 (IOB21A/DQS5); also elsewhere on the board
SDRAM_!RAS!: U$1.G1 (IOB24A/LVDS/DQ5); also elsewhere on the board
SDRAM_!WE!: U$1.H1 (IOB32B/LVDS/DQ6); also elsewhere on the board
SDRAM_A0: U$1.E2 (IOB12A/LVDS/DQ5); also elsewhere on the board
SDRAM_A1: U$1.D1 (IOB9B/DQS4); also elsewhere on the board
SDRAM_A2: U$1.D2 (IOB14B/LVDS/DQ5); also elsewhere on the board
SDRAM_A3: U$1.C1 (IOB14A/LVDS/DQ5); also elsewhere on the board
SDRAM_A4: U$1.J1 (IOB27A/GCLKT_5/DQ5); also elsewhere on the board
SDRAM_A5: U$1.J2 (IOB34A/LVDS/DQ6); also elsewhere on the board
SDRAM_A6: U$1.K1 (IOB34B/LVDS/DQ6); also elsewhere on the board
SDRAM_A7: U$1.K2 (IOB36B/LVDS/DQ6); also elsewhere on the board
SDRAM_A8: U$1.L1 (IOB38A/LVDS/DQ6); also elsewhere on the board
SDRAM_A9: U$1.L2 (IOB30A/GCLKT_4/LVDS/DQ6); also elsewhere on the board
SDRAM_A10: U$1.E1 (IOB16A/LVDS/DQ5); also elsewhere on the board
SDRAM_A11: U$1.M1 (IOB30B/GCLKC_4/LVDS/DQ6); also elsewhere on the board
SDRAM_A12: U$1.M2 (IOB43A/DQ6); also elsewhere on the board
SDRAM_BA0: U$1.F1 (IOB19B/DQ5); also elsewhere on the board
SDRAM_BA1: U$1.F2 (IOB16B/LVDS/DQ5); also elsewhere on the board
SDRAM_CKE: U$1.N1 (IOB42B/LVDS/DQ6); also elsewhere on the board
SDRAM_CLK: U$1.N2 (IOB41A/DQ6); also elsewhere on the board
SDRAM_DQ0: U$1.F4 (IOB18A/LVDS/DQ5); also elsewhere on the board
SDRAM_DQ1: U$1.F3 (IOB19A/DQ5); also elsewhere on the board
SDRAM_DQ2: U$1.E3 (IOB12B/LVDS/DQ5); also elsewhere on the board
SDRAM_DQ3: U$1.C5 (IOB2B/LVDS/DQ4); also elsewhere on the board
SDRAM_DQ4: U$1.D3 (IOB9A/DQS4); also elsewhere on the board
SDRAM_DQ5: U$1.C4 (IOL47A/LPLL2_T_FB/LVDS/DQ3); also elsewhere on the board
SDRAM_DQ6: U$1.C2 (IOB8B/LVDS/DQ4); also elsewhere on the board
SDRAM_DQ7: U$1.B3 (IOB13A/DQ5); also elsewhere on the board
SDRAM_DQ8: U$1.P2 (IOB44B/LVDS/DQ6); also elsewhere on the board
SDRAM_DQ9: U$1.R1 (IOB44A/LVDS/DQ6); also elsewhere on the board
SDRAM_DQ10: U$1.J4 (IOB35B/DQ6); also elsewhere on the board
SDRAM_DQ11: U$1.J3 (IOB27B/GCLKC_5/DQ5); also elsewhere on the board
SDRAM_DQ12: U$1.K4 (IOB39A/DQ6); also elsewhere on the board
SDRAM_DQ13: U$1.K3 (IOB36A/LVDS/DQ6); also elsewhere on the board
SDRAM_DQ14: U$1.L4 (IOB40B/LVDS/DQ6); also elsewhere on the board
SDRAM_DQ15: U$1.L3 (IOB38B/LVDS/DQ6); also elsewhere on the board
SDRAM_DQMH: U$1.P1 (IOB41B/DQ6); also elsewhere on the board
SDRAM_DQML: U$1.B1 (IOB8A/LVDS/DQ4); also elsewhere on the board
SD_CLK: U$1.N10 (IOR27A/GCLKT_2/DQ10); also elsewhere on the board
SD_CMD: U$1.R9 (IOR35A/FASTRD_N/D3/LVDS/DQ9); also elsewhere on the board
SD_D0: U$1.T9 (IOR38A/DIN/LVDS/DQ9); also elsewhere on the board
SD_D1: U$1.P9 (IOR38B/DOUT/LVDS/DQ9); also elsewhere on the board
SD_D2: U$1.R8 (IOR29B/GCLKC_3/LVDS/DQ9); also elsewhere on the board
SD_D3: U$1.T8 (IOR42B/LVDS/DQ9); also elsewhere on the board
SD_SW_A: U$1.T7 (IOR29A/GCLKT_3/LVDS/DQ9); also elsewhere on the board
SF_!CS!: U$1.M9 (IOR34A/MCS_N/D5/DQ9); also elsewhere on the board
SF_CLK: U$1.L10 (IOR34B/MCLK/D4/DQ9); also elsewhere on the board
SF_SI: U$1.R10 (IOR33B/MO/D6/LVDS/DQ9); also elsewhere on the board
SF_SO: U$1.P10 (IOR33A/MI/D7/LVDS/DQ9); also elsewhere on the board
USB_5V: C1.2, C4.2, C17.2, J1.A4-B9 (1_VBUS), J1.B4-A9 (2_VBUS), U$3.1 (EN), U$3.4 (IN), U$4.1 (EN), U$4.4 (IN), U$5.1 (EN), U$5.4 (IN); also elsewhere on the board
USB_DN: J1.A7 (DN1), J1.B7 (DN2); also elsewhere on the board
USB_DP: J1.A6 (DP1), J1.B6 (DP2); also elsewhere on the board
VCCPLLL: U$1.G10 (VCCPLLL_G10); also elsewhere on the board
VCCPLLR: U$1.K7 (VCCPLLR_K7); also elsewhere on the board

Notes on the sheet:
3V3
1V5
1V0
16-pin USB Type-C Female
GW2A-LV18PG256C8I7 IO Banks Power/Ground/EXTR Banks

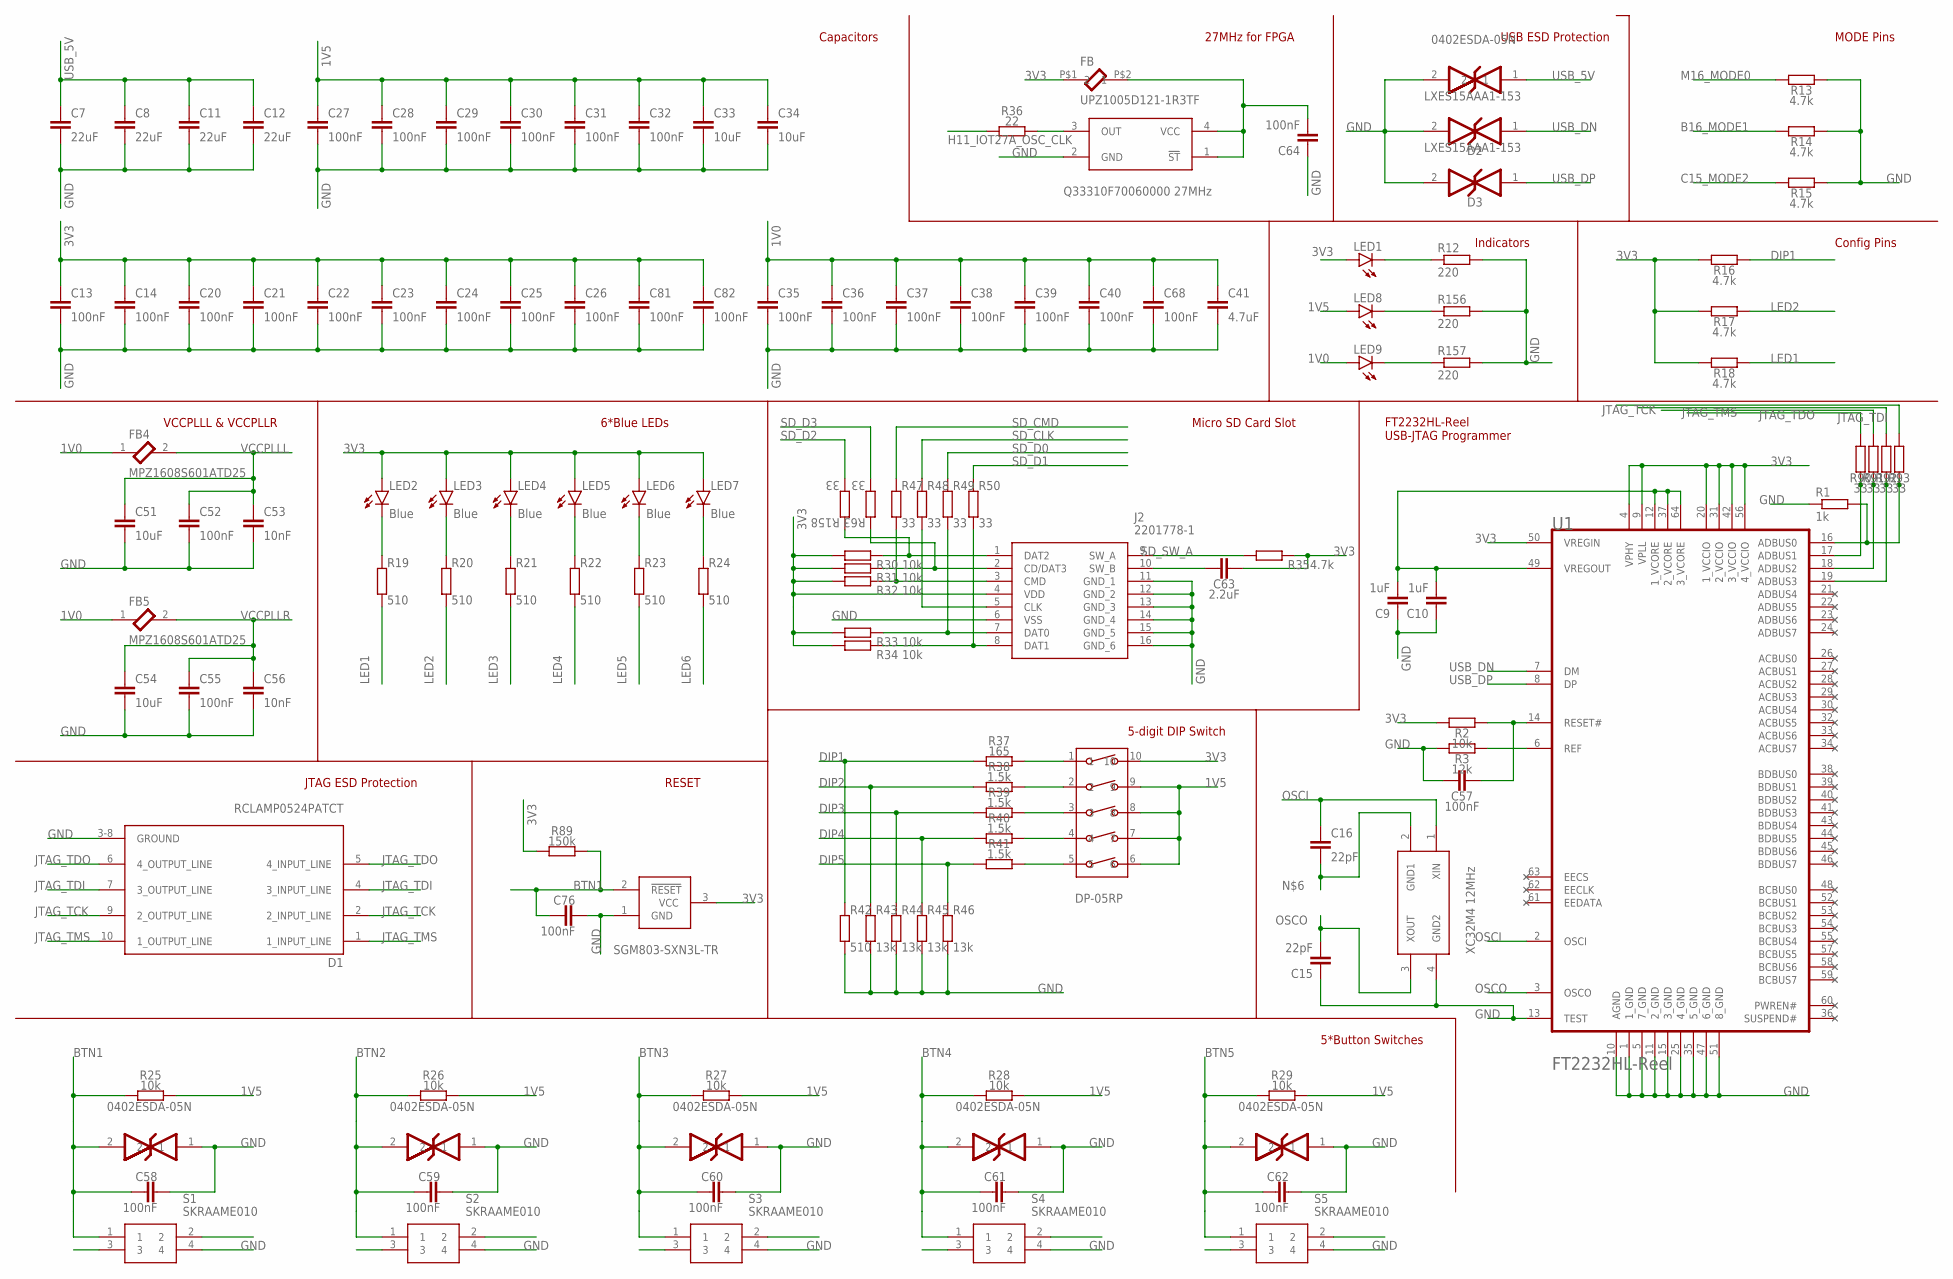
[picture p19: schematic design_main.sch, sheet 2]

Parts:
C7, C8, C11, C12: 22uF; C0805
C9, C10: 1uF; C0805
C13, C14, C20, C21, C22, C23, C24, C25, C26, C27, C28, C29, C30, C31, C32, C35, C36, C37, C38, C39, C40, C52, C55, C57, C58, C59, C60, C61, C62, C64, C68, C76, C81, C82: 100nF; C0805
C15, C16: 22pF; C0805
C33, C34, C51, C54: 10uF; C0805
C41: 4.7uF; C0805
C53, C56: 10nF; C0805
C63: 2.2uF; C0805
D1: SEMTECH_RCLAMP0524PATCTSEMTECH_RCLAMP0524PATCT_0_0; SEMTECH_RCLAMP0524PATCT_0
D2, D3: MURATA_LXES15AAA1-153MURATA_LXES15AAA1-153_0_0; MURATA_LXES15AAA1-153_0
FB: UPZ1005D121-1R3TF
FB4, FB5: TDK_MPZ1608S601ATD25TDK_MPZ1608S601ATD25_0_0; TDK_MPZ1608S601ATD25_0
J2: 2201778-1; 22017781
LED1, LED8, LED9: LEDSML0805; SML0805
LED2, LED3, LED4, LED5, LED6, LED7: Blue; SML0805
R1: 1k; R0805
R2, R25, R26, R27, R28, R29, R30, R31, R32, R33, R34: 10k; R0805
R3: 12k; R0805
R12, R156, R157: 220; R0805
R13, R14, R15, R16, R17, R18, R35: 4.7k; R0805
R19, R20, R21, R22, R23, R24, R42: 510; R0805
R36: 22; R0805
R37: 165; R0805
R38, R39, R40, R41: 1.5k; R0805
R43, R44, R45, R46: 13k; R0805
R47, R48, R49, R50, R63, R90, R91, R92, R93, R158: 33; R0805
R89: 150k; R0805
S1, S2, S3, S4, S5: SKRAAME010
U1: FTDI_FT2232HL-REELFTDI_FT2232HL-REEL_0_0; FTDI_FT2232HL-REEL_0
U$2: XC32M4-12MHZ
U$6, U$7, U$8, U$9, U$10, U$11: 0402ESDA-05N
U$13: DP-05RP
U$15: Q33310F70060000-27MHZ
U$16: SGM803-SXN3L-TR

Connections:
1V0: C35.2, C36.2, C37.2, C38.2, C39.2, C40.2, C41.2, C68.2, FB4.1, FB5.1, LED9.A; also elsewhere on the board
1V5: C27.2, C28.2, C29.2, C30.2, C31.2, C32.2, C33.2, C34.2, LED8.A, R25.2, R26.2, R27.2, R28.2, R29.2, U$13.6, U$13.7, U$13.8, U$13.9; also elsewhere on the board
3V3: C13.2, C14.2, C20.2, C21.2, C22.2, C23.2, C24.2, C25.2, C26.2, C63.1, C81.2, C82.2, FB.P$1 (1), J2.4 (VDD), LED1.A, LED2.A, LED3.A, LED4.A, LED5.A, LED6.A, LED7.A, R2.1, R16.2, R17.2, R18.2, R30.1, R31.1, R32.1, R33.1, R34.1, R35.2, R89.1, U1.4 (VPHY), U1.9 (VPLL), U1.20 (1_VCCIO), U1.31 (2_VCCIO), U1.42 (3_VCCIO), U1.50 (VREGIN), U1.56 (4_VCCIO), U$13.10, U$16.3 (VCC); also elsewhere on the board
B16_MODE1: R14.2; also elsewhere on the board
BTN1: C58.2, C76.2, R25.1, R89.2, S1.1, U$7.2, U$16.2 (!RESET!); also elsewhere on the board
BTN2: C59.2, R26.1, S2.1, U$8.2; also elsewhere on the board
BTN3: C60.2, R27.1, S3.1, U$9.2; also elsewhere on the board
BTN4: C61.2, R28.1, S4.1, U$10.2; also elsewhere on the board
BTN5: C62.2, R29.1, S5.1, U$11.2; also elsewhere on the board
C15_MODE2: R15.2; also elsewhere on the board
DIP1: R16.1, R37.1, R42.2; also elsewhere on the board
DIP2: R38.1, R43.2; also elsewhere on the board
DIP3: R39.1, R44.2; also elsewhere on the board
DIP4: R40.1, R45.2; also elsewhere on the board
DIP5: R41.1, R46.2; also elsewhere on the board
GND: C7.1, C8.1, C9.1, C10.1, C11.1, C12.1, C13.1, C14.1, C15.1, C20.1, C21.1, C22.1, C23.1, C24.1, C25.1, C26.1, C27.1, C28.1, C29.1, C30.1, C31.1, C32.1, C33.1, C34.1, C35.1, C36.1, C37.1, C38.1, C39.1, C40.1, C41.1, C51.1, C52.1, C53.1, C54.1, C55.1, C56.1, C57.2, C58.1, C59.1, C60.1, C61.1, C62.1, C64.1, C68.1, C76.1, C81.1, C82.1, D1.3-8 (GROUND), D2.2, D3.2, J2.6 (VSS), J2.11 (GND_1), J2.12 (GND_2), J2.13 (GND_3), J2.14 (GND_4), J2.15 (GND_5), J2.16 (GND_6), R1.1, R3.1, R12.2, R13.1, R14.1, R15.1, R42.1, R43.1, R44.1, R45.1, R46.1, R156.2, R157.2, S1.4, S2.4, S3.4, S4.4, S5.4, U1.1 (1_GND), U1.5 (7_GND), U1.10 (AGND), U1.11 (2_GND), U1.13 (TEST), U1.15 (3_GND), U1.25 (4_GND), U1.35 (5_GND), U1.47 (6_GND), U1.51 (8_GND), U$2.4 (GND2), U$6.2, U$7.1, U$8.1, U$9.1, U$10.1, U$11.1, U$15.2 (GND), U$16.1 (GND); also elsewhere on the board
H11_IOT27A_OSC_CLK: R36.2; also elsewhere on the board
JTAG_TCK: D1.2 (2_INPUT_LINE), D1.9 (2_OUTPUT_LINE), R93.1; also elsewhere on the board
JTAG_TDI: D1.4 (3_INPUT_LINE), D1.7 (3_OUTPUT_LINE), R90.1; also elsewhere on the board
JTAG_TDO: D1.5 (4_INPUT_LINE), D1.6 (4_OUTPUT_LINE), R91.1; also elsewhere on the board
JTAG_TMS: D1.1 (1_INPUT_LINE), D1.10 (1_OUTPUT_LINE), R92.1; also elsewhere on the board
LED1: R18.1, R19.2; also elsewhere on the board
LED2: R17.1, R20.2; also elsewhere on the board
LED3: R21.2; also elsewhere on the board
LED4: R22.2; also elsewhere on the board
LED5: R23.2; also elsewhere on the board
LED6: R24.2; also elsewhere on the board
M16_MODE0: R13.2; also elsewhere on the board
unnamed: R39.2, U$13.3
unnamed: C16.1, U$2.2 (GND1)
unnamed: R3.2, U1.6 (REF)
unnamed: C57.1, R2.2, U1.14 (RESET#)
unnamed: C63.2, J2.10 (SW_B)
unnamed: J2.2 (CD/DAT3), R31.2, R63.1
unnamed: C9.2, C10.2, U1.12 (1_VCORE), U1.37 (2_VCORE), U1.49 (VREGOUT), U1.64 (3_VCORE)
unnamed: LED1.C, R12.1
unnamed: J2.3 (CMD), R32.2, R47.2
unnamed: LED2.C, R19.1
unnamed: LED3.C, R20.1
unnamed: LED4.C, R21.1
unnamed: LED5.C, R22.1
unnamed: LED6.C, R23.1
unnamed: LED7.C, R24.1
unnamed: C64.2, FB.P$2 (2), U$15.1 (!ST!), U$15.4 (VCC)
unnamed: R36.1, U$15.3 (OUT)
unnamed: R37.2, U$13.1
unnamed: R38.2, U$13.2
unnamed: R40.2, U$13.4
unnamed: R41.2, U$13.5
unnamed: J2.5 (CLK), R48.2
unnamed: J2.7 (DAT0), R33.2, R49.2
unnamed: J2.8 (DAT1), R34.2, R50.2
unnamed: J2.1 (DAT2), R30.2, R158.1
unnamed: R1.2, R93.2, U1.16 (ADBUS0)
unnamed: R90.2, U1.17 (ADBUS1)
unnamed: R91.2, U1.18 (ADBUS2)
unnamed: R92.2, U1.19 (ADBUS3)
unnamed: LED8.C, R156.1
unnamed: LED9.C, R157.1
OSCI: C16.2, U1.2 (OSCI), U$2.1 (XIN)
OSCO: C15.2, U1.3 (OSCO), U$2.3 (XOUT)
SD_CLK: R48.1; also elsewhere on the board
SD_CMD: R47.1; also elsewhere on the board
SD_D0: R49.1; also elsewhere on the board
SD_D1: R50.1; also elsewhere on the board
SD_D2: R158.2; also elsewhere on the board
SD_D3: R63.2; also elsewhere on the board
SD_SW_A: J2.9 (SW_A), R35.1; also elsewhere on the board
USB_5V: C7.2, C8.2, C11.2, C12.2, U$6.1; also elsewhere on the board
USB_DN: D2.1, U1.7 (DM); also elsewhere on the board
USB_DP: D3.1, U1.8 (DP); also elsewhere on the board
VCCPLLL: C51.2, C52.2, C53.2, FB4.2; also elsewhere on the board
VCCPLLR: C54.2, C55.2, C56.2, FB5.2; also elsewhere on the board

Notes on the sheet:
Capacitors
27MHz for FPGA
USB ESD Protection
MODE Pins
Indicators
Config Pins
FT2232HL-Reel USB-JTAG Programmer
Micro SD Card Slot
6*Blue LEDs
VCCPLLL & VCCPLLR
RESET
JTAG ESD Protection
5-digit DIP Switch
5*Button Switches

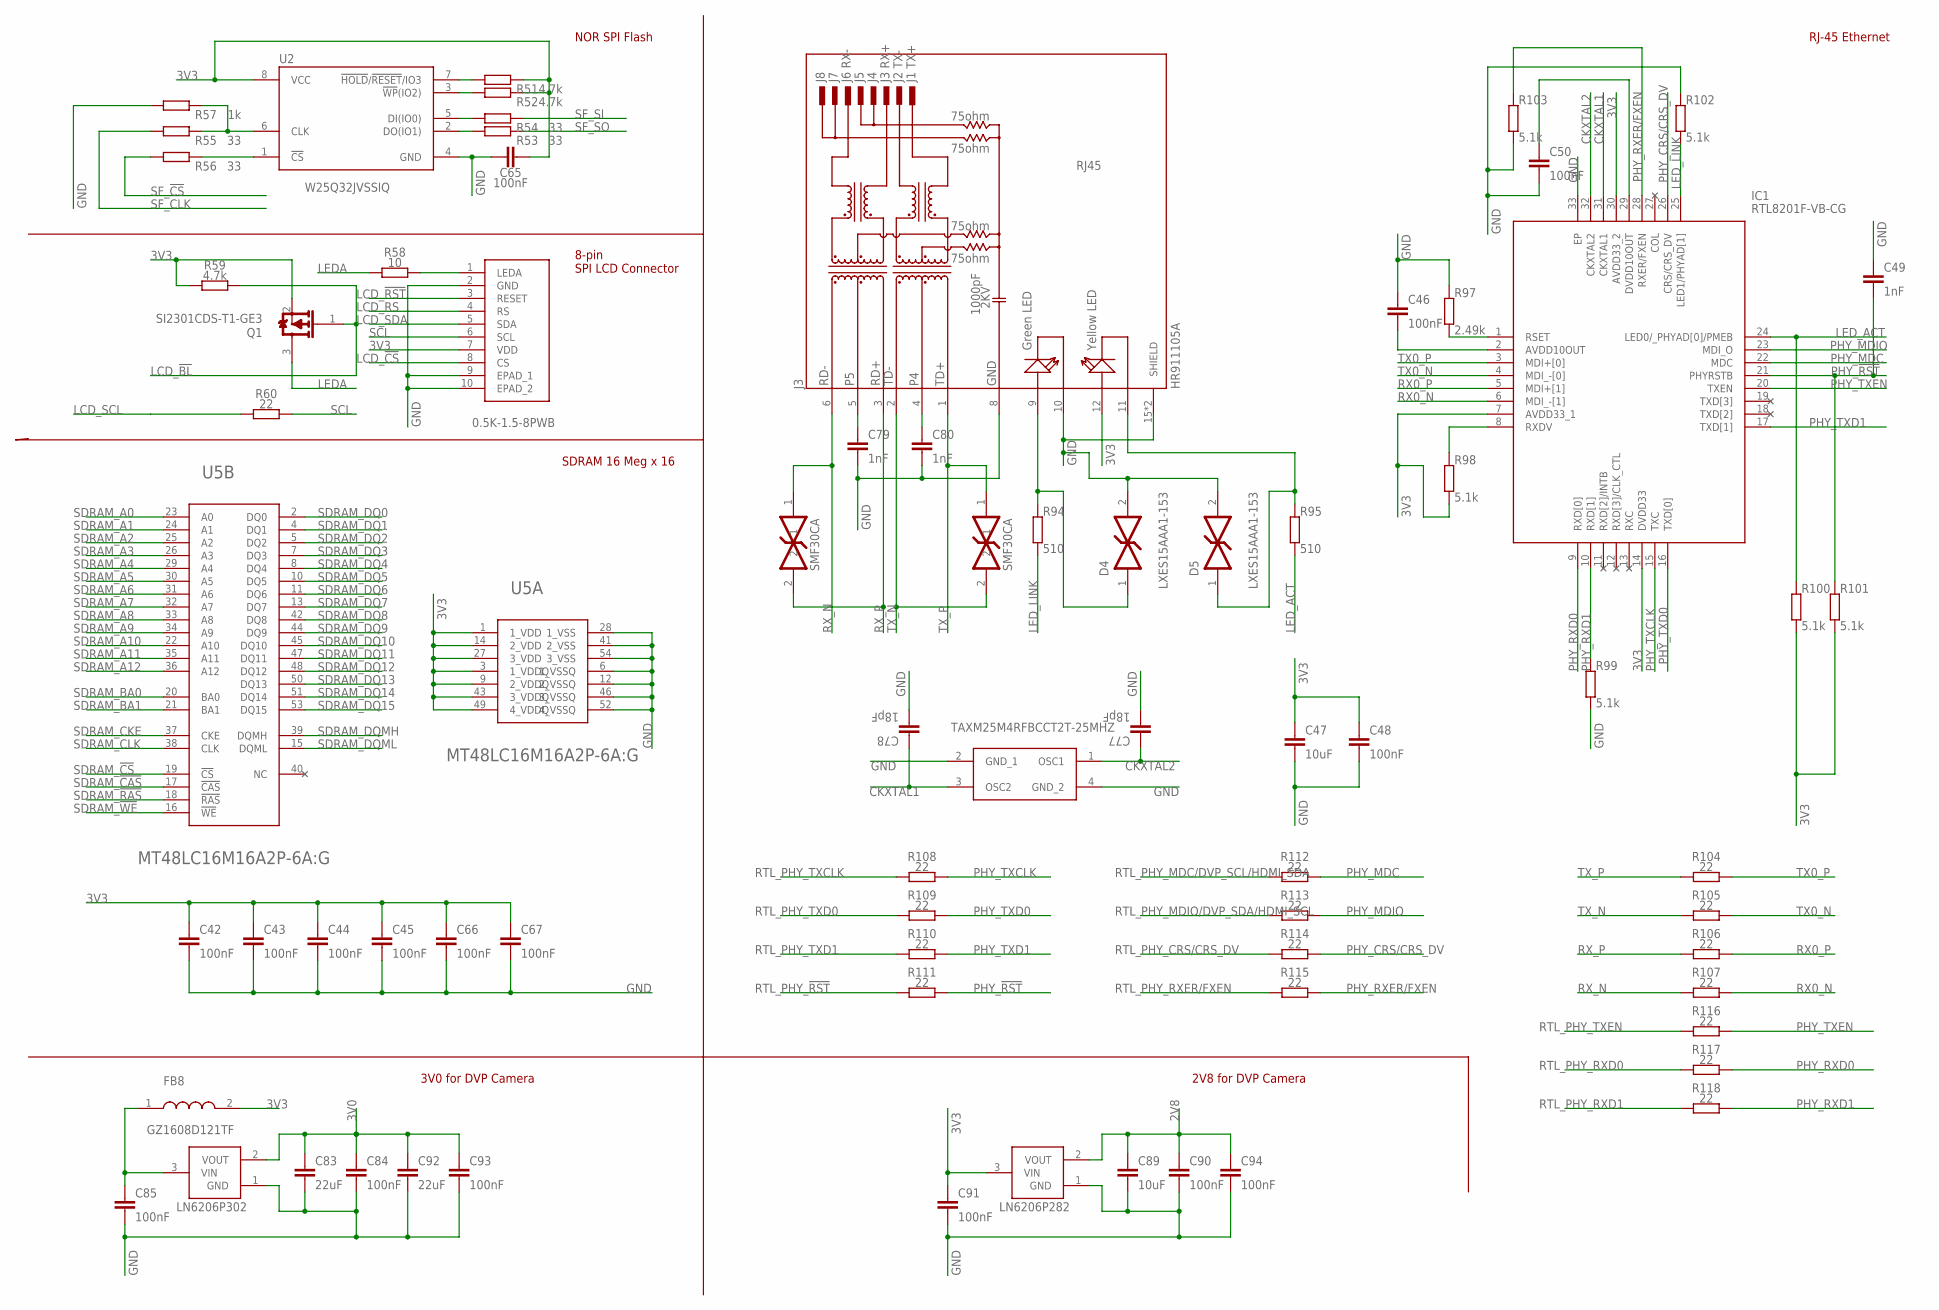
[picture p20: schematic design_main.sch, sheet 3]

Parts:
C42, C43, C44, C45, C46, C48, C50, C65, C66, C67, C84, C85, C90, C91, C93, C94: 100nF; C0805
C47, C89: 10uF; C0805
C49, C79, C80: 1nF; C0805
C77, C78: 18pF; C0805
C83, C92: 22uF; C0805
D4, D5: MURATA_LXES15AAA1-153MURATA_LXES15AAA1-153_0_0; MURATA_LXES15AAA1-153_0
FB8: SUNLORD_GZ1608D121TFSUNLORD_GZ1608D121TF_0_0; SUNLORD_GZ1608D121TF_0
IC1: RTL8201F-VB-CG; QFN50P500X500X100-33N
J3: HR911105A; HANRUN_HR911105A
Q1: VISHAY_SI2301CDS-T1-GE3VISHAY_SI2301CDS-T1-GE3_0_0; VISHAY_SI2301CDS-T1-GE3_0
R51, R52, R59: 4.7k; R0805
R53, R54, R55, R56: 33; R0805
R57: 1k; R0805
R58: 10; R0805
R60, R104, R105, R106, R107, R108, R109, R110, R111, R112, R113, R114, R115, R116, R117, R118: 22; R0805
R94, R95: 510; R0805
R97: 2.49k; R0805
R98, R99, R100, R101, R102, R103: 5.1k; R0805
U2: WINBOND_W25Q32JVSSIQWINBOND_W25Q32JVSSIQ_0_0; WINBOND_W25Q32JVSSIQ_0
U5: MICRON_MT48LC16M16A2P-6A-GMICRON_MT48LC16M16A2P-6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; MICRON_MT48LC16M16A2P-6A-G_0
U$14: 0.5K-1.5-8PWB
U$17: TAXM25M4RFBCCT2T-25MHZ
U$18, U$19: SMF30CA
U$20: LN6206P302
U$22: LN6206P282

Connections:
2V8: C89.2, C90.2, C94.2, U$22.2 (VOUT); also elsewhere on the board
3V0: C83.2, C84.2, C92.2, C93.2, U$20.2 (VOUT); also elsewhere on the board
3V3: C42.2, C43.2, C44.2, C45.2, C47.2, C48.2, C65.1, C66.2, C67.2, C91.2, FB8.2, IC1.7 (AVDD33_1), IC1.14 (DVDD33), IC1.30 (AVDD33_2), J3.12 (YA), Q1.2 (S), R51.2, R52.2, R59.1, R98.1, R100.1, R101.1, U2.8 (VCC), U5.1 (1_VDD), U5.3 (1_VDDQ), U5.9 (2_VDDQ), U5.14 (2_VDD), U5.27 (3_VDD), U5.43 (3_VDDQ), U5.49 (4_VDDQ), U$14.7 (VDD), U$22.3 (VIN); also elsewhere on the board
CKXTAL1: C78.2, IC1.31 (CKXTAL1), U$17.3 (OSC2)
CKXTAL2: C77.2, IC1.32 (CKXTAL2), U$17.1 (OSC1)
GND: C42.1, C43.1, C44.1, C45.1, C46.2, C47.1, C48.1, C49.2, C50.1, C65.2, C66.1, C67.1, C77.1, C78.1, C79.1, C80.1, C83.1, C84.1, C85.1, C89.1, C90.1, C91.1, C92.1, C93.1, C94.1, D4.2, D5.2, IC1.33 (EP), J3.8 (GND), J3.10 (GC), J3.15 (SHIELD), J3.16 (SHIELD), R57.1, R97.1, R99.1, R102.1, R103.2, U2.4 (GND), U5.6 (1_VSSQ), U5.12 (2_VSSQ), U5.28 (1_VSS), U5.41 (2_VSS), U5.46 (3_VSSQ), U5.52 (4_VSSQ), U5.54 (3_VSS), U$14.2 (GND), U$14.9 (EPAD_1), U$14.10 (EPAD_2), U$17.2 (GND_1), U$17.4 (GND_2), U$20.1 (GND), U$22.1 (GND); also elsewhere on the board
LCD_!BL!: Q1.1 (G), R59.2; also elsewhere on the board
LCD_!CS!: U$14.8 (CS); also elsewhere on the board
LCD_!RST!: U$14.3 (RESET); also elsewhere on the board
LCD_RS: U$14.4 (RS); also elsewhere on the board
LCD_SCL: R60.1; also elsewhere on the board
LCD_SDA: U$14.5 (SDA); also elsewhere on the board
LEDA: Q1.3 (D), R58.1
LED_ACT: IC1.24 (LED0/_PHYAD[0]/PMEB), R95.2, R100.2
LED_LINK: IC1.25 (LED1/PHYAD[1]), R94.2, R102.2
unnamed: R52.1, U2.3 (!WP!(IO2))
unnamed: R58.2, U$14.1 (LEDA)
unnamed: R51.1, U2.7 (!HOLD!/!RESET!/IO3)
unnamed: R53.1, U2.2 (DO(IO1))
unnamed: R54.1, U2.5 (DI(IO0))
unnamed: R55.2, R57.2, U2.6 (CLK)
unnamed: R56.2, U2.1 (!CS!)
unnamed: IC1.1 (RSET), R97.2
unnamed: C46.1, IC1.2 (AVDD10OUT)
unnamed: C79.2, J3.5
unnamed: C80.2, J3.4
unnamed: D4.1, J3.9 (GA), R94.1
unnamed: D5.1, J3.11 (YC), R95.1
unnamed: IC1.8 (RXDV), R98.2
unnamed: C50.2, IC1.29 (DVDD10OUT)
unnamed: C85.2, FB8.1, U$20.3 (VIN)
PHY_!RST!: C49.1, IC1.21 (PHYRSTB), R101.2, R111.2
PHY_CRS/CRS_DV: IC1.26 (CRS/CRS_DV), R114.2
PHY_MDC: IC1.22 (MDC), R112.2
PHY_MDIO: IC1.23 (MDI_O), R113.2
PHY_RXD0: IC1.9 (RXD[0]), R117.2
PHY_RXD1: IC1.10 (RXD[1]), R99.2, R118.2
PHY_RXER/FXEN: IC1.28 (RXER/FXEN), R103.1, R115.2
PHY_TXCLK: IC1.15 (TXC), R108.2
PHY_TXD0: IC1.16 (TXD[0]), R109.2
PHY_TXD1: IC1.17 (TXD[1]), R110.2
PHY_TXEN: IC1.20 (TXEN), R116.2
RTL_PHY_!RST!: R111.1; also elsewhere on the board
RTL_PHY_CRS/CRS_DV: R114.1; also elsewhere on the board
RTL_PHY_MDC/DVP_SCL/HDMI_SDA: R112.1; also elsewhere on the board
RTL_PHY_MDIO/DVP_SDA/HDMI_SCL: R113.1; also elsewhere on the board
RTL_PHY_RXD0: R117.1; also elsewhere on the board
RTL_PHY_RXD1: R118.1; also elsewhere on the board
RTL_PHY_RXER/FXEN: R115.1; also elsewhere on the board
RTL_PHY_TXCLK: R108.1; also elsewhere on the board
RTL_PHY_TXD0: R109.1; also elsewhere on the board
RTL_PHY_TXD1: R110.1; also elsewhere on the board
RTL_PHY_TXEN: R116.1; also elsewhere on the board
RX0_N: IC1.6 (MDI_-[1]), R107.2
RX0_P: IC1.5 (MDI+[1]), R106.2
RX_N: J3.6 (RD-), R107.1, U$18.1
RX_P: J3.3 (RD+), R106.1, U$18.2
SCL: R60.2, U$14.6 (SCL)
SDRAM_!CAS!: U5.17 (!CAS!); also elsewhere on the board
SDRAM_!CS!: U5.19 (!CS!); also elsewhere on the board
SDRAM_!RAS!: U5.18 (!RAS!); also elsewhere on the board
SDRAM_!WE!: U5.16 (!WE!); also elsewhere on the board
SDRAM_A0: U5.23 (A0); also elsewhere on the board
SDRAM_A1: U5.24 (A1); also elsewhere on the board
SDRAM_A2: U5.25 (A2); also elsewhere on the board
SDRAM_A3: U5.26 (A3); also elsewhere on the board
SDRAM_A4: U5.29 (A4); also elsewhere on the board
SDRAM_A5: U5.30 (A5); also elsewhere on the board
SDRAM_A6: U5.31 (A6); also elsewhere on the board
SDRAM_A7: U5.32 (A7); also elsewhere on the board
SDRAM_A8: U5.33 (A8); also elsewhere on the board
SDRAM_A9: U5.34 (A9); also elsewhere on the board
SDRAM_A10: U5.22 (A10); also elsewhere on the board
SDRAM_A11: U5.35 (A11); also elsewhere on the board
SDRAM_A12: U5.36 (A12); also elsewhere on the board
SDRAM_BA0: U5.20 (BA0); also elsewhere on the board
SDRAM_BA1: U5.21 (BA1); also elsewhere on the board
SDRAM_CKE: U5.37 (CKE); also elsewhere on the board
SDRAM_CLK: U5.38 (CLK); also elsewhere on the board
SDRAM_DQ0: U5.2 (DQ0); also elsewhere on the board
SDRAM_DQ1: U5.4 (DQ1); also elsewhere on the board
SDRAM_DQ2: U5.5 (DQ2); also elsewhere on the board
SDRAM_DQ3: U5.7 (DQ3); also elsewhere on the board
SDRAM_DQ4: U5.8 (DQ4); also elsewhere on the board
SDRAM_DQ5: U5.10 (DQ5); also elsewhere on the board
SDRAM_DQ6: U5.11 (DQ6); also elsewhere on the board
SDRAM_DQ7: U5.13 (DQ7); also elsewhere on the board
SDRAM_DQ8: U5.42 (DQ8); also elsewhere on the board
SDRAM_DQ9: U5.44 (DQ9); also elsewhere on the board
SDRAM_DQ10: U5.45 (DQ10); also elsewhere on the board
SDRAM_DQ11: U5.47 (DQ11); also elsewhere on the board
SDRAM_DQ12: U5.48 (DQ12); also elsewhere on the board
SDRAM_DQ13: U5.50 (DQ13); also elsewhere on the board
SDRAM_DQ14: U5.51 (DQ14); also elsewhere on the board
SDRAM_DQ15: U5.53 (DQ15); also elsewhere on the board
SDRAM_DQMH: U5.39 (DQMH); also elsewhere on the board
SDRAM_DQML: U5.15 (DQML); also elsewhere on the board
SF_!CS!: R56.1; also elsewhere on the board
SF_CLK: R55.1; also elsewhere on the board
SF_SI: R54.2; also elsewhere on the board
SF_SO: R53.2; also elsewhere on the board
TX0_N: IC1.4 (MDI_-[0]), R105.2
TX0_P: IC1.3 (MDI+[0]), R104.2
TX_N: J3.2 (TD-), R105.1, U$19.2
TX_P: J3.1 (TD+), R104.1, U$19.1

Notes on the sheet:
RJ45
NOR SPI Flash
8-pin SPI LCD Connector
SDRAM 16 Meg x 16
RJ-45 Ethernet
3V0 for DVP Camera
2V8 for DVP Camera
