TheWayForward/Domesitc-FPGA-Demo-Board/PCB/design_main.brd

## EAGLE design PCB/design_main.brd (continued)

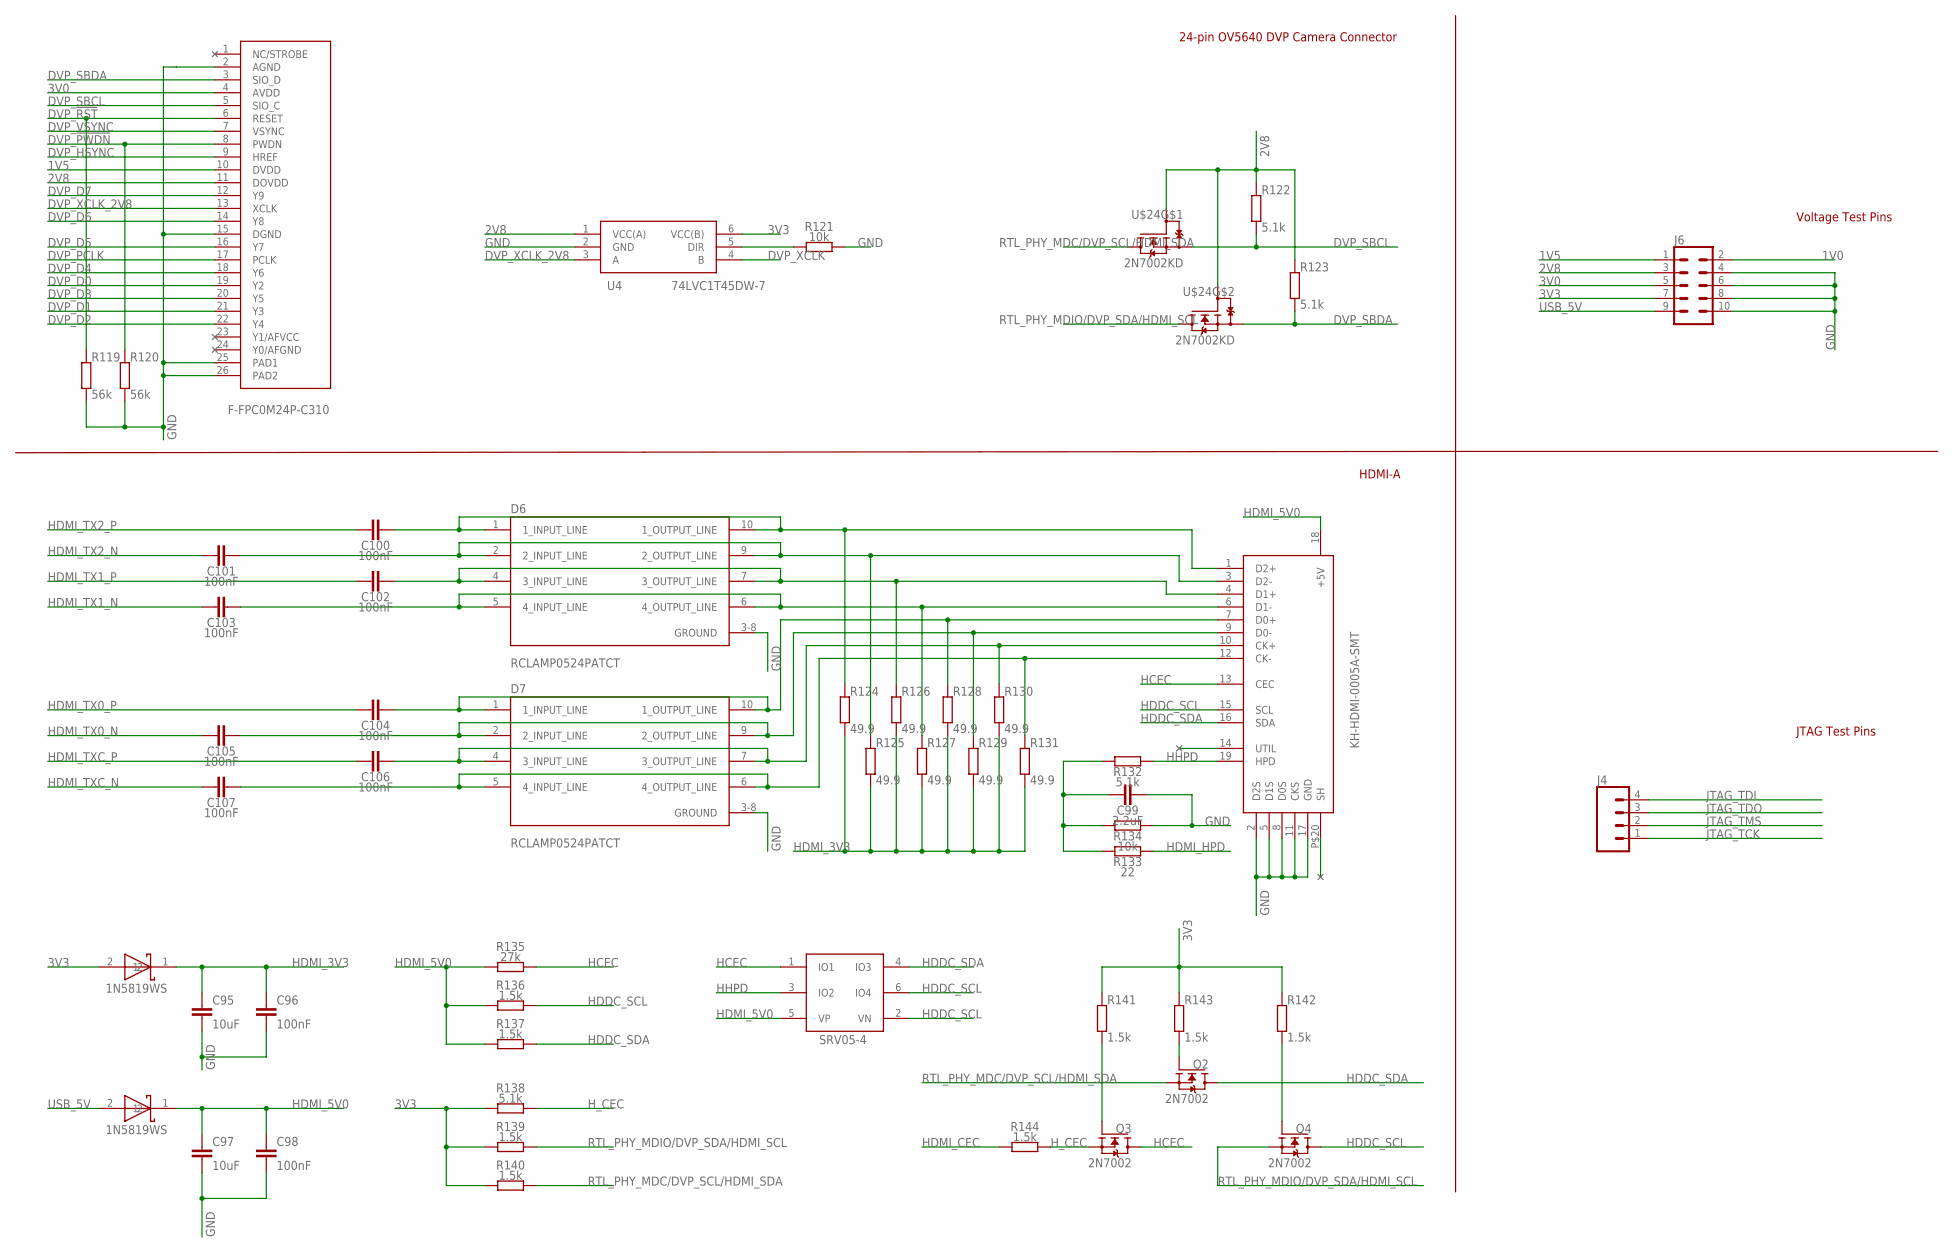
[picture p21: schematic design_main.sch, sheet 4]

Parts:
C95, C97: 10uF; C0805
C96, C98, C100, C101, C102, C103, C104, C105, C106, C107: 100nF; C0805
C99: 2.2uF; C0805
D6, D7: SEMTECH_RCLAMP0524PATCTSEMTECH_RCLAMP0524PATCT_0_0; SEMTECH_RCLAMP0524PATCT_0
J4: CONN_04PTH; 1X04
J6: CONN_05X2PTH; 2X5
Q2, Q3, Q4: 2N7002; SOT95P240X111-3N
R119, R120: 56k; R0805
R121, R134: 10k; R0805
R122, R123, R132, R138: 5.1k; R0805
R124, R125, R126, R127, R128, R129, R130, R131: 49.9; R0805
R133: 22; R0805
R135: 27k; R0805
R136, R137, R139, R140, R141, R142, R143, R144: 1.5k; R0805
U4: 74LVC1T45DW-7; SOT65P210X110-6N
U$23: F-FPC0M24P-C310
U$24: 2N7002KD
U$25, U$26: 1N5819WS
U$27: KH-HDMI-0005A-SMT
U$28: SRV05-4

Connections:
1V0: J6.2; also elsewhere on the board
1V5: J6.1, U$23.10 (DVDD); also elsewhere on the board
2V8: J6.3, R122.2, R123.2, U4.1 (VCC(A)), U$23.11 (DOVDD), U$24.P$2 (G1), U$24.P$5 (G2); also elsewhere on the board
3V0: J6.5, U$23.4 (AVDD); also elsewhere on the board
3V3: J6.7, R138.1, R139.1, R140.1, R141.1, R142.1, R143.1, U4.6 (VCC(B)), U$25.2; also elsewhere on the board
DVP_!PWDN!: R120.1, U$23.8 (PWDN); also elsewhere on the board
DVP_!RST!: R119.1, U$23.6 (RESET); also elsewhere on the board
DVP_D0: U$23.19 (Y2); also elsewhere on the board
DVP_D1: U$23.21 (Y3); also elsewhere on the board
DVP_D2: U$23.22 (Y4); also elsewhere on the board
DVP_D3: U$23.20 (Y5); also elsewhere on the board
DVP_D4: U$23.18 (Y6); also elsewhere on the board
DVP_D5: U$23.16 (Y7); also elsewhere on the board
DVP_D6: U$23.14 (Y8); also elsewhere on the board
DVP_D7: U$23.12 (Y9); also elsewhere on the board
DVP_HSYNC: U$23.9 (HREF); also elsewhere on the board
DVP_PCLK: U$23.17 (PCLK); also elsewhere on the board
DVP_SBCL: R122.1, U$23.5 (SIO_C), U$24.P$1 (S1)
DVP_SBDA: R123.1, U$23.3 (SIO_D), U$24.P$4 (S2)
DVP_VSYNC: U$23.7 (VSYNC); also elsewhere on the board
DVP_XCLK: U4.4 (B); also elsewhere on the board
DVP_XCLK_2V8: U4.3 (A), U$23.13 (XCLK)
GND: C95.1, C96.1, C97.1, C98.1, C99.1, D6.3-8 (GROUND), D7.3-8 (GROUND), J6.4, J6.6, J6.8, J6.10, R119.2, R120.2, R121.2, R134.2, U4.2 (GND), U$23.2 (AGND), U$23.15 (DGND), U$23.25 (PAD1), U$23.26 (PAD2), U$27.2 (D2S), U$27.5 (D1S), U$27.8 (D0S), U$27.11 (CKS), U$27.17 (GND); also elsewhere on the board
HCEC: Q3.3 (D), R135.2, U$27.13 (CEC), U$28.1 (IO1)
HDDC_SCL: Q4.3 (D), R136.2, U$27.15 (SCL), U$28.2 (VN), U$28.6 (IO4)
HDDC_SDA: Q2.3 (D), R137.2, U$27.16 (SDA), U$28.4 (IO3)
HDMI_3V3: C95.2, C96.2, R124.2, R125.2, R126.2, R127.2, R128.2, R129.2, R130.2, R131.2, U$25.1
HDMI_5V0: C97.2, C98.2, R135.1, R136.1, R137.1, U$26.1, U$27.18 (+5V), U$28.5 (VP)
HDMI_CEC: R144.1; also elsewhere on the board
HDMI_HPD: R133.2; also elsewhere on the board
HDMI_TX0_N: C105.2; also elsewhere on the board
HDMI_TX0_P: C104.2; also elsewhere on the board
HDMI_TX1_N: C103.2; also elsewhere on the board
HDMI_TX1_P: C102.2; also elsewhere on the board
HDMI_TX2_N: C101.2; also elsewhere on the board
HDMI_TX2_P: C100.2; also elsewhere on the board
HDMI_TXC_N: C107.2; also elsewhere on the board
HDMI_TXC_P: C106.2; also elsewhere on the board
HHPD: R132.2, U$27.19 (HPD), U$28.3 (IO2)
H_CEC: Q3.2 (S), R138.2, R144.2
JTAG_TCK: J4.1; also elsewhere on the board
JTAG_TDI: J4.4; also elsewhere on the board
JTAG_TDO: J4.3; also elsewhere on the board
JTAG_TMS: J4.2; also elsewhere on the board
unnamed: R121.1, U4.5 (DIR)
unnamed: C100.1, D6.1 (1_INPUT_LINE), D6.10 (1_OUTPUT_LINE), R124.1, U$27.1 (D2+)
unnamed: C101.1, D6.2 (2_INPUT_LINE), D6.9 (2_OUTPUT_LINE), R125.1, U$27.3 (D2-)
unnamed: C102.1, D6.4 (3_INPUT_LINE), D6.7 (3_OUTPUT_LINE), R126.1, U$27.4 (D1+)
unnamed: C103.1, D6.5 (4_INPUT_LINE), D6.6 (4_OUTPUT_LINE), R127.1, U$27.6 (D1-)
unnamed: C104.1, D7.1 (1_INPUT_LINE), D7.10 (1_OUTPUT_LINE), R128.1, U$27.7 (D0+)
unnamed: C105.1, D7.2 (2_INPUT_LINE), D7.9 (2_OUTPUT_LINE), R129.1, U$27.9 (D0-)
unnamed: C106.1, D7.4 (3_INPUT_LINE), D7.7 (3_OUTPUT_LINE), R130.1, U$27.10 (CK+)
unnamed: C107.1, D7.5 (4_INPUT_LINE), D7.6 (4_OUTPUT_LINE), R131.1, U$27.12 (CK-)
unnamed: C99.2, R132.1, R133.1, R134.1
unnamed: Q2.1 (G), R143.2
unnamed: Q3.1 (G), R141.2
unnamed: Q4.1 (G), R142.2
RTL_PHY_MDC/DVP_SCL/HDMI_SDA: Q2.2 (S), R140.2, U$24.P$6 (D1); also elsewhere on the board
RTL_PHY_MDIO/DVP_SDA/HDMI_SCL: Q4.2 (S), R139.2, U$24.P$3 (D2); also elsewhere on the board
USB_5V: J6.9, U$26.2; also elsewhere on the board

Notes on the sheet:
24-pin OV5640 DVP Camera Connector
HDMI-A
Voltage Test Pins
JTAG Test Pins

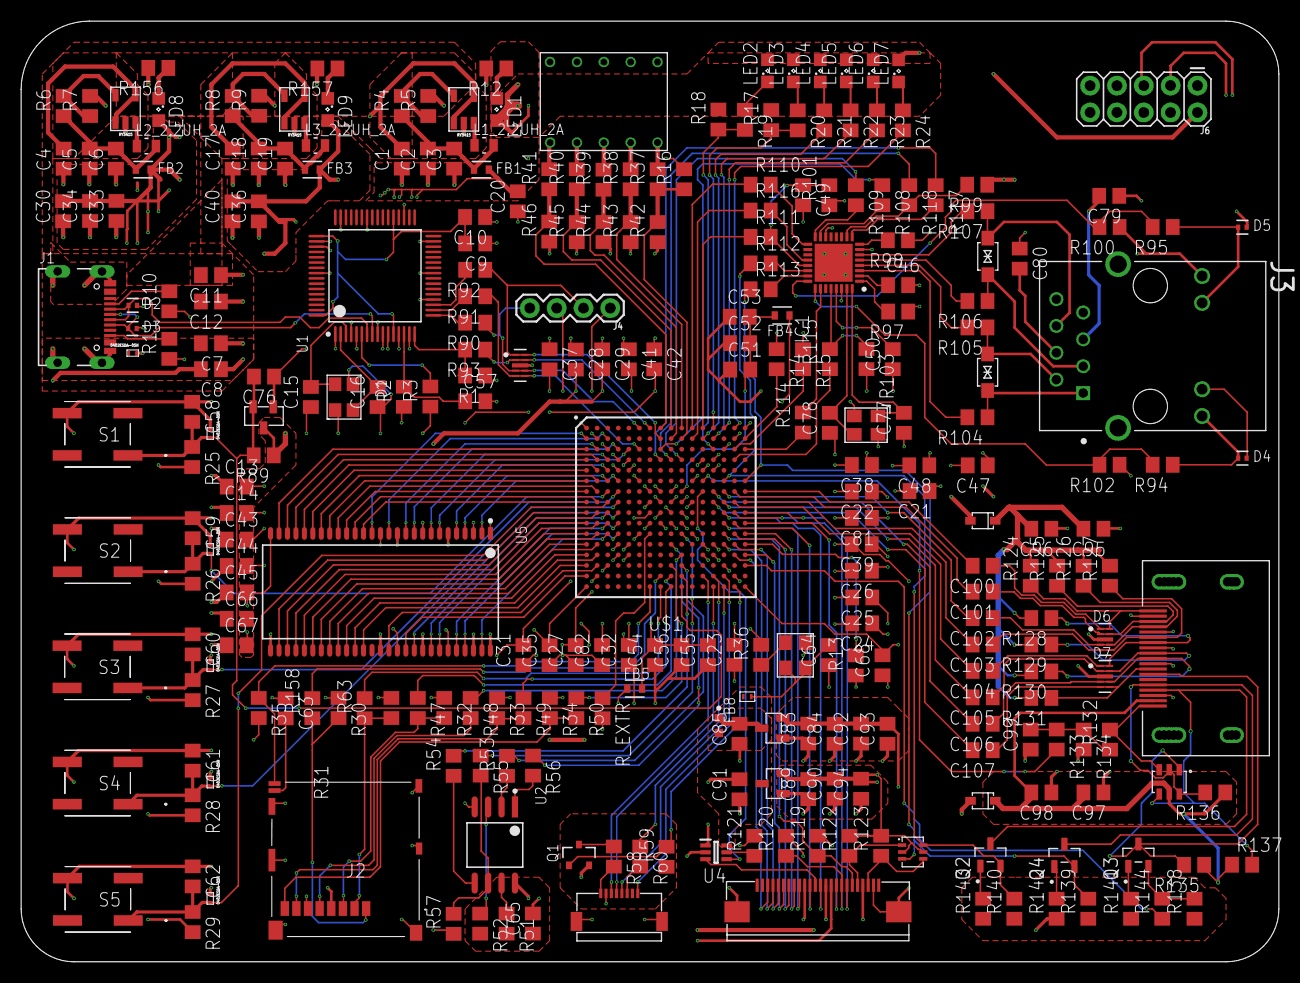
[picture p22: board design_main.brd from above]

Board: 4 copper layers, 119.0 x 89.0 mm, 288 parts (0 on the bottom side), 235 nets.
